Marcus-Reiss/CAD-Backup-LEMI/Backup-20241219-20250121T215628Z-001/Backup-20241219/LEMI_platform_v2024/Parts_new/Sala-de-controle/karman-office-armchair-with-glides-option-1.snapshot.5/Rendering/Karman 004 02a.png

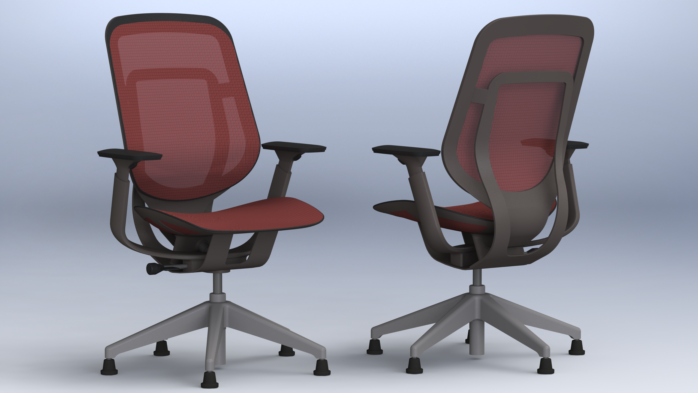
Backup-20241219-20250121T215628Z-001/Backup-20241219/LEMI_platform_v2024/Parts_new/Sala-de-controle/karman-office-armchair-with-glides-option-1.snapshot.5/Rendering/Karman 004 02a.png
