Marcus-Reiss/CAD-Backup-LEMI/Backup_20250225/LEMI_platform_v2024/Parts_new/Sala-de-controle/karman-office-armchair-with-glides-option-1.snapshot.5/Rendering/karman r-100 g-50 b100.png

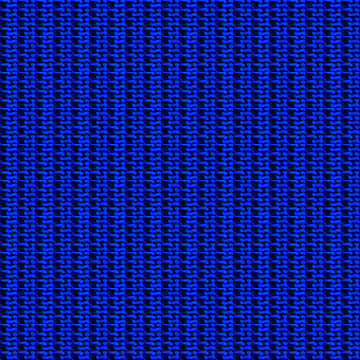
Backup_20250225/LEMI_platform_v2024/Parts_new/Sala-de-controle/karman-office-armchair-with-glides-option-1.snapshot.5/Rendering/karman r-100 g-50 b100.png
