Marcus-Reiss/CAD-Backup-LEMI/Backup_20250225/LEMI_platform_v2024/Mapa-Misturadores_LEMI-v2024/LowPressure_Setup1_XYZcoordinates.IGS.txt

SolidWorks IGES file using analytic representation for surfaces         S      1
1H,,1H;,5HPart1,128HC:\Users\IGOR RANGEL\Documents\LEMI\3Dmap\LEMI_platfG      1
orm_v2024\Mapa-Misturadores_LEMI-v2024\LowPressure_Setup1_XYZcoordinatesG      2
.IGS,15HSolidWorks 2023,15HSolidWorks 2023,32,308,15,308,15,5HPart1,1., G      3
2,2HMM,50,0.125,13H241102.171719,1E-08,499990.,11HIGOR RANGEL,,11,0,13H2G      4
41102.171719;                                                           G      5
     116       1       0       0       0                        00000000D      1
     116       0       0       1       0                               0D      2
     116       2       0       0       0                        00000000D      3
     116       0       0       1       0                               0D      4
     116       3       0       0       0                        00000000D      5
     116       0       0       1       0                               0D      6
     116       4       0       0       0                        00000000D      7
     116       0       0       1       0                               0D      8
     116       5       0       0       0                        00000000D      9
     116       0       0       1       0                               0D     10
     116       6       0       0       0                        00000000D     11
     116       0       0       1       0                               0D     12
     116       7       0       0       0                        00000000D     13
     116       0       0       1       0                               0D     14
     116       8       0       0       0                        00000000D     15
     116       0       0       1       0                               0D     16
     116       9       0       0       0                        00000000D     17
     116       0       0       1       0                               0D     18
     116      10       0       0       0                        00000000D     19
     116       0       0       1       0                               0D     20
     116      11       0       0       0                        00000000D     21
     116       0       0       1       0                               0D     22
     116      12       0       0       0                        00000000D     23
     116       0       0       1       0                               0D     24
     116      13       0       0       0                        00000000D     25
     116       0       0       1       0                               0D     26
     116      14       0       0       0                        00000000D     27
     116       0       0       1       0                               0D     28
     116      15       0       0       0                        00000000D     29
     116       0       0       1       0                               0D     30
     116      16       0       0       0                        00000000D     31
     116       0       0       1       0                               0D     32
     116      17       0       0       0                        00000000D     33
     116       0       0       1       0                               0D     34
     116      18       0       0       0                        00000000D     35
     116       0       0       1       0                               0D     36
     116      19       0       0       0                        00000000D     37
     116       0       0       1       0                               0D     38
     116      20       0       0       0                        00000000D     39
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
     402       0       0      16      15                3DSKETCH       1D    508
     314     270       0       0       0                        00000200D    509
     314       0       8       1       0                               0D    510
116,2400.,1025.,-19080.,;                                              1P      1
116,2050.,1025.,-19080.,;                                              3P      2
116,1680.,1025.,-19080.,;                                              5P      3
116,2400.,662.,-19080.,;                                               7P      4
116,2063.710678119,662.,-19080.,;                                      9P      5
116,2055.348877629,662.704155423,-19080.,;                            11P      6
116,2049.138564487,664.170579093,-19080.,;                            13P      7
116,2044.5765065,665.806023374,-19080.,;                              15P      8
116,2038.765908876,668.666889248,-19080.,;                            17P      9
116,2033.093103225,672.470718351,-19080.,;                            19P     10
116,2028.355339059,676.644660941,-19080.,;                            21P     11
116,1854.17766953,850.82233047,-19080.,;                              23P     12
116,2400.,200.,-19080.,;                                              25P     13
116,1995.710678119,200.,-19080.,;                                     27P     14
116,1989.309977636,200.411382018,-19080.,;                            29P     15
116,1982.84984418,201.682312241,-19080.,;                             31P     16
116,1976.5765065,203.806023374,-19080.,;                              33P     17
116,1969.571678389,207.376618,-19080.,;                               35P     18
116,1964.704420392,210.774855236,-19080.,;                            37P     19
116,1960.355339059,214.644660941,-19080.,;                            39P     20
116,1555.17766953,619.82233047,-19080.,;                              41P     21
116,1150.,1025.,-19080.,;                                             43P     22
116,850.,1025.,-19080.,;                                              45P     23
116,400.,1025.,-19080.,;                                              47P     24
116,361.751666746,1025.,-19078.167131998,;                            49P     25
116,329.307433241,1025.,-19073.703646167,;                            51P     26
116,299.100864855,1025.,-19067.065064979,;                            53P     27
116,272.770546388,1025.,-19059.226404848,;                            55P     28
116,237.07420108,1025.,-19045.315184528,;                             57P     29
116,205.138467915,1025.,-19029.32647096,;                             59P     30
116,176.780825428,1025.,-19011.923485314,;                            61P     31
116,148.979949959,1025.,-18991.430464915,;                            63P     32
116,117.157287525,1025.,-18962.842712475,;                            65P     33
116,90.619203002,1025.,-18933.541954021,;                             67P     34
116,68.932834013,1025.,-18904.487263794,;                             69P     35
116,52.628181233,1025.,-18878.325035047,;                             71P     36
116,34.967722097,1025.,-18843.558662531,;                             73P     37
116,19.307056975,1025.,-18802.77167072,;                              75P     38
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
