Marcus-Reiss/CAD-Backup-LEMI/Backup_20250225/LEMI_platform_v2024/Projeto Separador/Imagens Comporta/Imagem.pptx

## Comporta

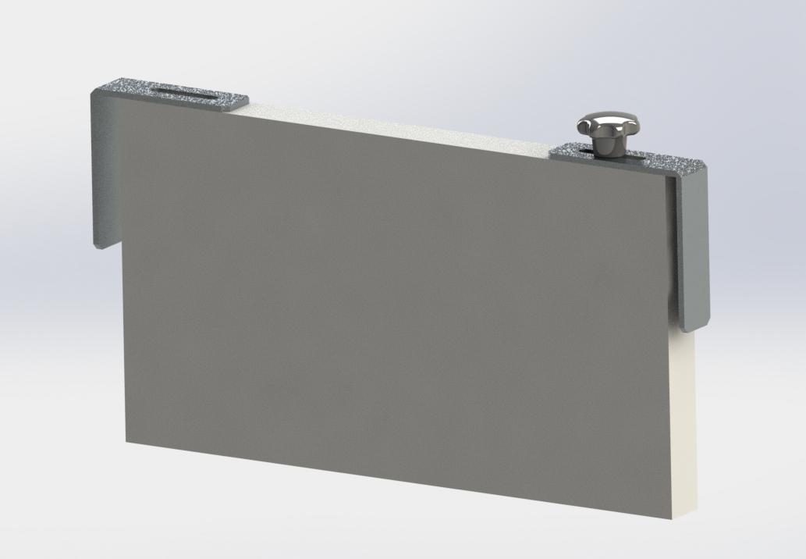
[picture p3: figure]
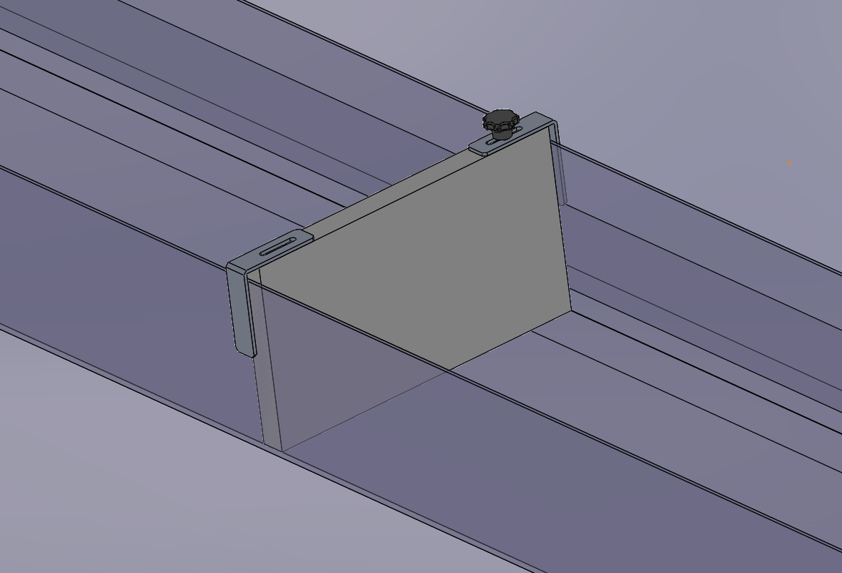
[picture p4: figure]
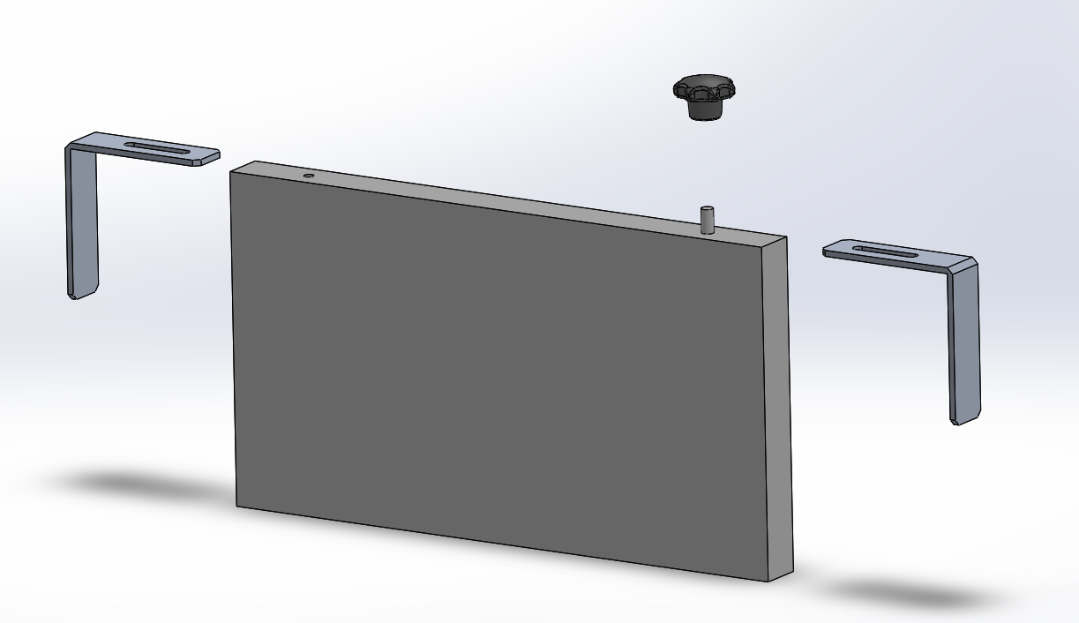
[picture p5: figure]
