Marcus-Reiss/CAD-Backup-LEMI/Backup-20241219-20250121T215628Z-001/Backup-20241219/LEMI_platform_v2024/Projeto Separador/Imagens Comporta/Comporta.PNG

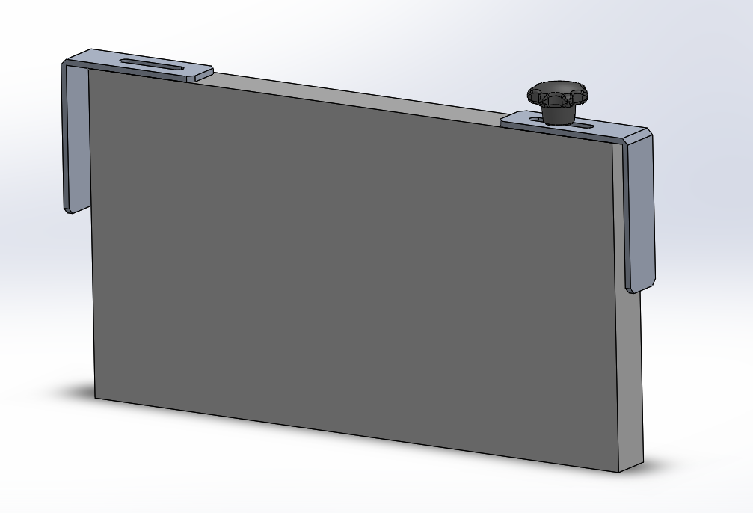
Backup-20241219-20250121T215628Z-001/Backup-20241219/LEMI_platform_v2024/Projeto Separador/Imagens Comporta/Comporta.PNG
