Marcus-Reiss/CAD-Backup-LEMI/Backup-20241219-20250121T215628Z-001/Backup-20241219/LEMI_platform_v2024/Projeto Separador/Imagens tubo ajustavel/WhatsApp Image 2019-05-02 at 08.36.58.jpeg

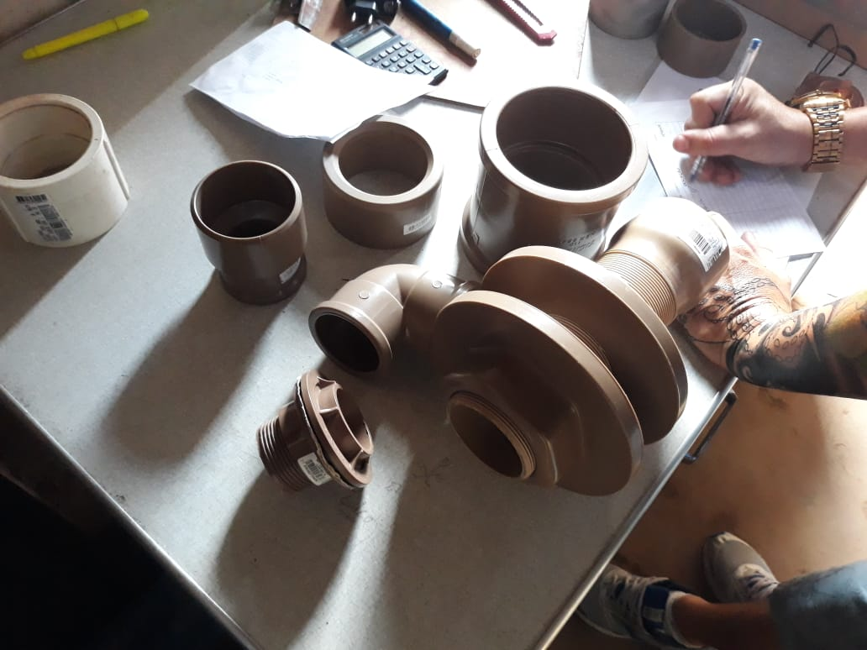
Backup-20241219-20250121T215628Z-001/Backup-20241219/LEMI_platform_v2024/Projeto Separador/Imagens tubo ajustavel/WhatsApp Image 2019-05-02 at 08.36.58.jpeg
