Marcus-Reiss/CAD-Backup-LEMI/Backup_20250225/LEMI_platform_v2024/Parts_new/Nova estrutura raios gamma 2024/CONTAPDF_900704486684.pdf

## IGOR RANGEL CORREA FERREIRA R FRANCISCO GENTIL DE GUZZI 605 AP 3 PQ S F JARDIM 13563-360 SAO CARLOS SP

### Nota Fiscal

### Conta de Energia Elétrica Nº 355746883 Série C Data de Emissão: 26/03/2024

### Data de Apresentação: 01/04/2024

### Pág: 01 de 01 Conta Contrato N° 310134338550

### Leitura Próximo Mês: 24/04/2024

Lote | Roteiro de leitura | N°. Medidor | PN
16 | SACBU223-00000388 | 22953156 | 717821069

## Reservado ao Fisco F9B6.3183.D08E.EDB9.543D.EF03.6CC7.0E30

Mantenha seus dados sempre atualizados, alguns itens determinam a tarifa e tributação de sua fatura de energia elétrica. Solicite os serviços disponíveis em nosso site com rapidez e segurança e reserve mais tempo para você em seu dia-a-dia. Mais informações acesse o endereço que consta no verso de sua conta.

IGOR RANGEL CORREA FERREIRA
R FRANCISCO GENTIL DE GUZZI, 605 AP 3 PQ S F JARDIM
13563-360 SAO CARLOS - SP

CPF: 105.638.006-31
CLASSIFICAÇÃO: Convencional B1 Residencial - Bifásico 220 / 127 V

0800 010 1010

## www.cpfl.com.br

## 717821069 INSTALAÇÃO

4001679179

MAR/2024 | 08/04/2024 | **********

Cod.
115

Descrição da Operação
N° 900704486684

Mês
Ref.

Quant.
Faturada

Unid.
Med.

Tarifa com
Tributos R$

Valor Total
da Operação
R$

Base Cálculo
ICMS R$

Aliq.
ICMS

ICMS Base Cálculo
PIS/COFINS

PIS
0,83%

COFINS
3,83%
0605 Consumo Uso Sistema [KWh]-TUSD | MAR/24 | 89,000 | kWh | 0,38977529 | 34,69 | 34,69 | 0,29 | 1,33
0601 Consumo - TE | MAR/24 | 89,000 | kWh | 0,33449439 | 29,77 | 29,77 | 0,25 | 1,14
Total Distribuidora | | | | | 64,46
Total Consolidado | 64,46 | 64,46 | 0,54 | 2,47

Bandeiras
Tarifárias
(Dias)

Verde
06 Dias
Verde
26 Dias
2024 MAR lllllllllllllllllllllllllllllllllllllllllllllllllllllllllllllllllllllllllll | 89 | 32 | Consumo | TUSD | TE
Consumo kWh | 0,37162000 | 0,31884000
Nº | Energia | Leitura | Leitura | Fator | ConsumoTaxa de Perda | Leitura
26/03/2024 24/02/2024 | Multipl. | [kWh] | [%] | Próximo Mês
22953156 | Ativa | 11074 | 10985 | 1,00 | 89 | 24/04/2024

### Para consulta dos indicadores acesse nosso site www.cpfl.com.br

Junto com sua fatura segue Contrato de Adesão.
CDE Escassez Hídrica TUSD R$ 0,41 TE R$ 0,33
Não Pague. Para sua comodidade o valor devido R$ 64,46 será cobrado, sem acréscimo em conta futura. Caso não queira esta opção, é possível solicitar o código de barras
para pagamento e o cancelamento desse serviço através

de nossos canais de atendimento.

CódDébAut-Banco
310134338550

Nota Fiscal
Conta de Energia Elétrica
N° 355746883 Série C

### Total a Pagar (R$)

**********

### Data de Vencimento

08/04/2024

## NÃO RECEBER. O VALOR DESTA FATURA SERÁ INSERIDO EM CONTA FUTURA ISENTO DE ENCARGOS SAIBA MAIS EM: www.cpfl.com.br/contaminima
