Marcus-Reiss/CAD-Backup-LEMI/Backup_20250225/LEMI_platform_v2024/Parts_new/Sala-de-controle/254839.pdf

## HIDROTUBE HIDRAULICA INDL LTDA

### AV. AMBROSIO FUMAGALLI, 1907 13.485-333 - LIMEIRA - SP CNPJ: 02.587.023/0001-70 - IE 417.148.125.112 FONE: (19) 3452-5313

## Orçamento de Venda - Nº 254839

1/3

04/03/2024
Revisão.: 07/03/2024

# CONSUMIDOR 8

À
FUNDACAO DE APOIO A UNIVERSIDADE DE SAO | CNPJ : 68.314.830/0001-27
Endereço: AVENIDA AFRANIO PEIXOTO,14
Bairro: BUTANTA | Cidade: SAO PAULO | UF: SP CEP: 05.507-000
A/C ANDRE | Fone: ( )
Depto: | Fax: ( )
E-mail: la.buenomonteiro@gmail.com .
Item | Código | Descrição | ICMS | IPI | NCM | Qtde | UN | Unitário | Total | Entrega Vlr. ST
1 | 3894 | TUBO INOX 304L SCH-40s S/C. 2 | 18,00% 0,00 % 7306.40.00 | 60,00 | MT | 317,3850 | 19.043,10 10 DIAS | 0,00
2 | 3897 | TUBO INOX 304L SCH-40s S/C. 4 | 18,00% 0,00 % 7306.40.00 | 6,00 | MT | 984,8617 | 5.909,17 10 DIAS | 0,00
3 | 7466 | FLANGE INOX 304L W.N ANSI 300 RF 2 * | 0,00% 0,00 % 7307.21.00 | 35,00 | PC | 543,3751 | 19.018,13 5 DIAS | 0,00
4 | 7336 | FLANGE INOX 304L W.N ANSI 150 RF 2 | 18,00% 0,00 % 7307.21.00 | 8,00 | PC | 396,9000 | 3.175,20 5 DIAS | 0,00
5 | 31073 | JUNTA | METALICA | ESPIRALADA
| | I304/GRAF/AC RF 300 2
18,00% 0,00 % 8484.20.00 | 50,00 | PC | 20,9070 | 1.045,35 IMEDIATO 0,00
6 | 7463 | FLANGE INOX 304L W.N ANSI 300 RF 1 | 0,00% 0,00 % 7307.21.00 | 4,00 | PC | 272,4750 | 1.089,90 5 DIAS | 0,00
7 | 31070 | JUNTA METALICA ESPIRALADA I304/GRAF/AC RF 300 1
8 | 34388 | VALVULA DE ESFERA DIRECIONAL MULTIVIAS DIAMETRO 2" PASSAGEM PLENA ACO INOX MICROFUNDIDO ASTM A351 GRAU CF8 SI/E.316 FLANGE SOLDADO CLASSE 300 (ASME B16.5) RANHURA ESPIRAL (MSSP-6) VEDACOES EM PTFE REFORCADO ACIONAMENTO MANUAL
9 | 34388 | VALVULA DE ESFERA DIRECIONAL MULTIVIAS DIAMETRO 2" PASSAGEM PLENA ACO INOX MICROFUNDIDO ASTM A351 GRAU CF8 ESFERA EM ACO INOX MICROFUNDIDO ASTM A351 GRAU CF8M E HASTE EM ACO INOX AISI 304, COM PARAFUSOS EM ACO CARBONO ZINCADO (SAE J 429) E PORCAS EM ACO CARBONO (SAE J 995) FLANGE SOLDADO CLASSE 150 (ASME B16.5) RANHURA ESPIRAL (MSSP-6) VEDACOES EM PTFE PURO ACIONAMENTO MANUAL POR ALAVANCA GIRO 90 GRAU
10 | 28370 | VAL.ESF.TRIP.S-I304 TP P.PLENA FL-300 2 MGA
18,00% 0,00 % 8484.20.00 | 4,00 | PC | 12,2725 | 49,09 IMEDIATO 0,00
0,00% 0,00 % 8481.80.95 | 1,00 | PC 4.685,1100 | 4.685,11 25 DIAS | 0,00
0,00% 0,00 % 8481.80.95 | 2,00 | PC 3.982,6350 | 7.965,27 25 DIAS | 0,00
0,00% 0,00 % 8481.80.95 | 3,00 | PC 1.326,3467 | 3.979,04 15 DIAS | 0,00

### FONE: (19) 3452-5313

## Orçamento de Venda - Nº 254839

2/3

Item | Código | Descrição | ICMS | IPI | NCM | Qtde | UN | Unitário | Total | Entrega Vlr. ST
11 | 28730 | VALVULA DE ESFERA TRIPARTIDA SERIE
| | 1000, CLASSE 300, DIAMETRO 2" PASSAGEM PLENA CONSTRUCAO EM INOX MICROFUNDIDO ASTM A351 GRAU CF8 ESFERA EM ACO INOX MICROF. ASTM A351 GR. CF8 E HASTE EM ACO INOX AISI 304, COM PARAFUSOS EM ASTM A193 GR. B7 SEM REVESTIMENTO E PORCAS EM ASTM
A194 | GR. | 2H | SEM | REVESTIMENTO
| | CONEXAO FLANGE CLASSE 300 (CONFORME ASME B16.5)
RESSALTO | COM | RANHURA | ESPIRAL
| | (CONFORME MSS SP-6) VEDACOES EM PTFE PURO
ACIONAMENTO | PNEUMATICO | POR
| | ATUADOR RETORNO MOLA SR85 COM ENTRADA DE AR PARA ACIONAMENTO DE 6 BAR E SOLENOIDE 3/2 24VCC E INDICADOR DE POSICAO E06
0,00% 0,00 % 8481.80.95 | 3,00 | PC 3.065,0400 | 9.195,12 25 DIAS | 0,00
12 | 7466 | FLANGE INOX 304L W.N ANSI 300 RF 2 * | 0,00% 0,00 % 7307.21.00 | 4,00 | PC | 543,3750 | 2.173,50 5 DIAS | 0,00
13 | 9103 | VAL.RETENCAO TIPO DISCO INOX WAFER VRD32 2" VEDAÇÃO EM TEFLON | 0,00% 0,00 % 8481.30.00 | 2,00 | PC | 801,4500 | 1.602,90 45 DIAS | 0,00
14 | 7466 | FLANGE INOX 304L W.N ANSI 300 RF 2 * | 0,00% 0,00 % 7307.21.00 | 2,00 | PC | 543,3750 | 1.086,75 5 DIAS | 0,00
15 | 5684 | REDUCAO CONC. INOX 304L SCH-40s 4 X 2 * 0,00% 0,00 % 7307.23.00 | 4,00 | PC | 281,9250 | 1.127,70 5 DIAS | 0,00
16 | 29887 | VALVULA | DE | ESFERA | DIRECIONAL
| | MULTIVIAS DIAMETRO 1" PASSAGEM PLENA ACO INOX MICROFUNDIDO ASTM A351 GRAU CF8 ESFERA EM ACO INOX MICROFUNDIDO ASTM A351 GRAU CF8M E HASTE EM ACO INOX AISI 304, COM PARAFUSOS EM ACO INOX (AISI 304) E PORCAS EM ACO INOX (AISI 304) FLANGE SOLDADO CLASSE 150 (ASME B16.5) RANHURA ESPIRAL (MSSP-6) VEDACOES EM PTFE REFORCADO ACIONAMENTO MANUAL POR ALAVANCA GIRO 90 GRAUS
0,00% 0,00 % 8481.80.95 | 1,00 | PC 2.364,8000 | 2.364,80 15 DIAS | 0,00
17 | 29863 | CURVA R.L. 90 INOX 304L SCH-40S 2 HT | 18,00% 3,25 % 7307.23.00 | 20,00 | PC | 59,8990 | 1.197,98 IMEDIATO 0,00 ST (R$) 0,00 IPI (R$) 38,93 FCP ST (R$) 0,00 TOTAL (R$) 84.747,04

Obs.: FATURAMENTO MEDIANTE APROVACAO DO CADASTRO

CONDIÇÕES DE PAGAMENTO | 28 DDL
VALIDADE DA PROPOSTA | 5 DIAS
PRAZO DE ENTREGA | ACIMA - SALVO VENDA PRÉVIA

### FONE: (19) 3452-5313

## Orçamento de Venda - Nº 254839

3/3

Item | Código | Descrição | ICMS | IPI | NCM | Qtde | UN | Unitário | Total | Entrega Vlr. ST
LOCAL DE ENTREGA | SEU ALMOXARIFADO
TIPO DE FRETE | CIF
PESO APROXIMADO | 757 KG

| | | | | | | | | | Atenciosamente,

DOUGLAS ALBERTO SILVA MANCINI
