Marcus-Reiss/CAD-Backup-LEMI/Backup-20241219-20250121T215628Z-001/Backup-20241219/LEMI_platform_v2024/Parts_new/aluminium_profile/profile-aluminium-3030/Aluminium Profile 3030 30x30 mm/Aluminium Profile 3030 30x30 mm.JPG

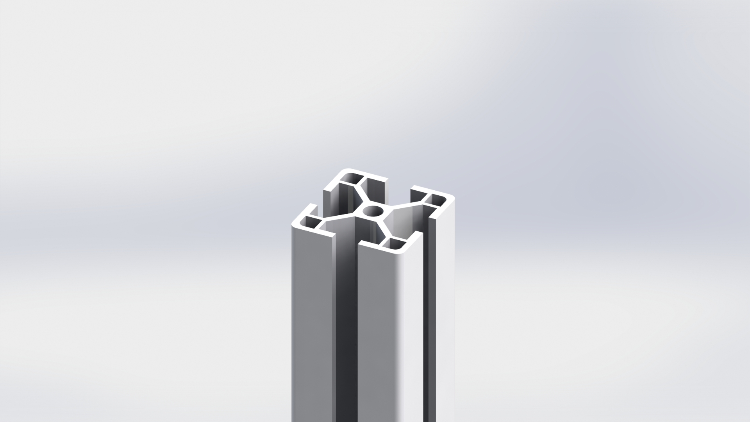
Backup-20241219-20250121T215628Z-001/Backup-20241219/LEMI_platform_v2024/Parts_new/aluminium_profile/profile-aluminium-3030/Aluminium Profile 3030 30x30 mm/Aluminium Profile 3030 30x30 mm.JPG
