Marcus-Reiss/CAD-Backup-LEMI/Backup-20241219-20250121T215628Z-001/Backup-20241219/LEMI_platform_v2024/Parts_new/aluminium_profile/weldments/Profile T-Slot 50 (2).JPG

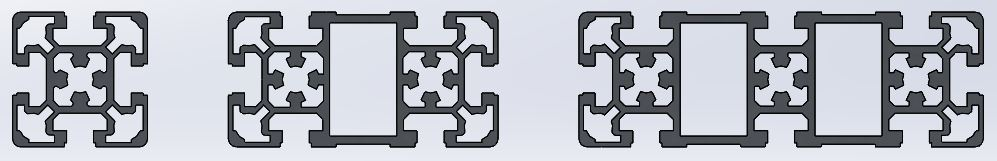
Backup-20241219-20250121T215628Z-001/Backup-20241219/LEMI_platform_v2024/Parts_new/aluminium_profile/weldments/Profile T-Slot 50 (2).JPG
