Marcus-Reiss/CAD-Backup-LEMI/Backup-20241219-20250121T215628Z-001/Backup-20241219/LEMI_platform_v2024/Parts_new/drawer_Slide/Guia/Riel50CM_completo.bmp

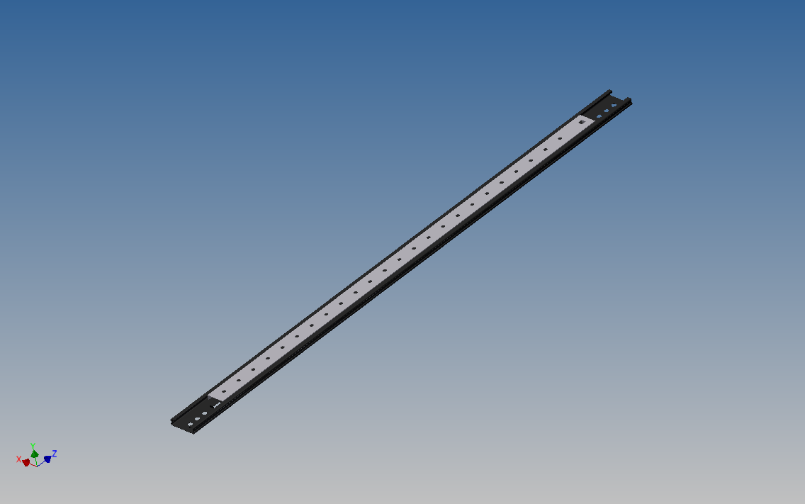
Backup-20241219-20250121T215628Z-001/Backup-20241219/LEMI_platform_v2024/Parts_new/drawer_Slide/Guia/Riel50CM_completo.bmp
