Marcus-Reiss/CAD-Backup-LEMI/Backup-20241219-20250121T215628Z-001/Backup-20241219/LEMI_platform_v2024/Parts_new/pneumatic-parts-1.snapshot.30/pnomatik.png

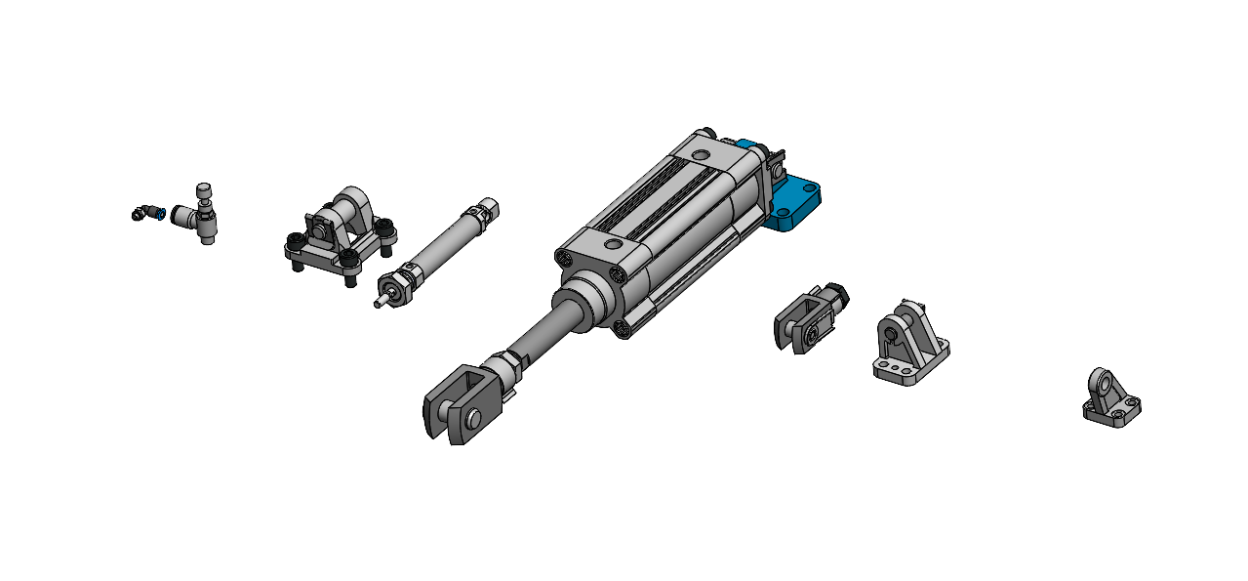
Backup-20241219-20250121T215628Z-001/Backup-20241219/LEMI_platform_v2024/Parts_new/pneumatic-parts-1.snapshot.30/pnomatik.png
