Marcus-Reiss/CAD-Backup-LEMI/Backup-20241219-20250121T215628Z-001/Backup-20241219/LEMI_platform_v2024/Parts_new/Valvulas e flanges/abracadeira-u-/Abra├ºadeira ├ÿ64 - 2.1_2_.JPG

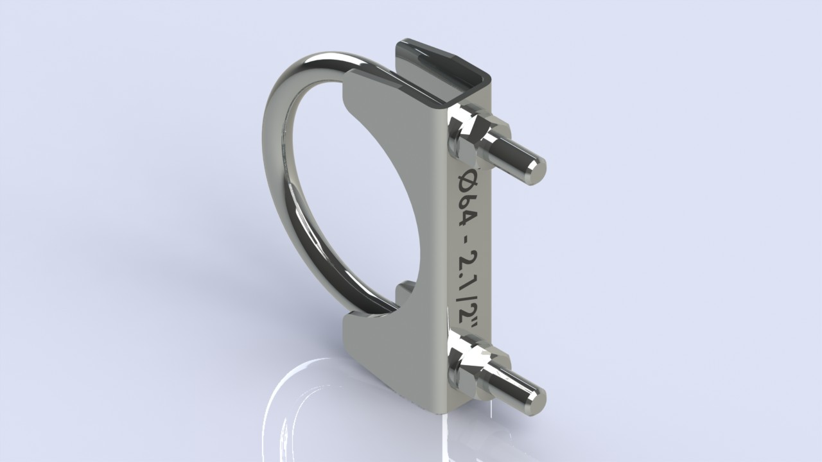
Backup-20241219-20250121T215628Z-001/Backup-20241219/LEMI_platform_v2024/Parts_new/Valvulas e flanges/abracadeira-u-/Abra├ºadeira ├ÿ64 - 2.1_2_.JPG
