Marcus-Reiss/CAD-Backup-LEMI/Backup-20241219-20250121T215628Z-001/Backup-20241219/LEMI_platform_v2024/Parts_new/Valvulas e flanges/pipe-exhaust-clamp-m8-54-mm-u-bolt-8-54-1.snapshot.5/Render.png

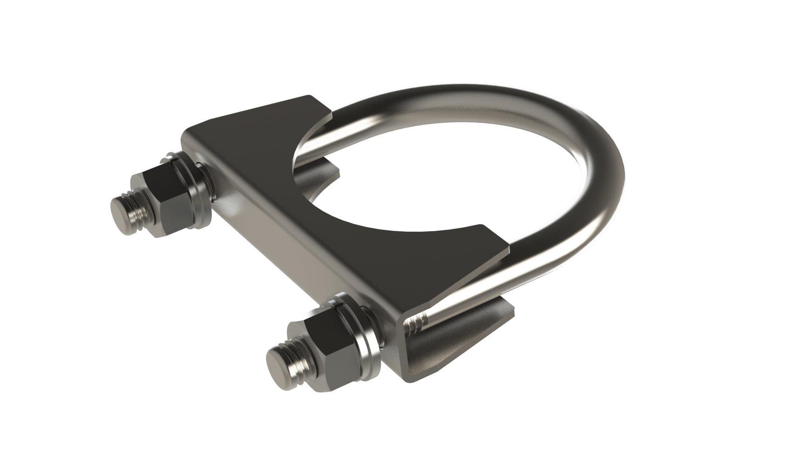
Backup-20241219-20250121T215628Z-001/Backup-20241219/LEMI_platform_v2024/Parts_new/Valvulas e flanges/pipe-exhaust-clamp-m8-54-mm-u-bolt-8-54-1.snapshot.5/Render.png
