Marcus-Reiss/CAD-Backup-LEMI/Backup-20241219-20250121T215628Z-001/Backup-20241219/LEMI_platform_v2024/Parts_new/CAD Estrutura Raios Gama/guia/Montagem Guia.SLDASM

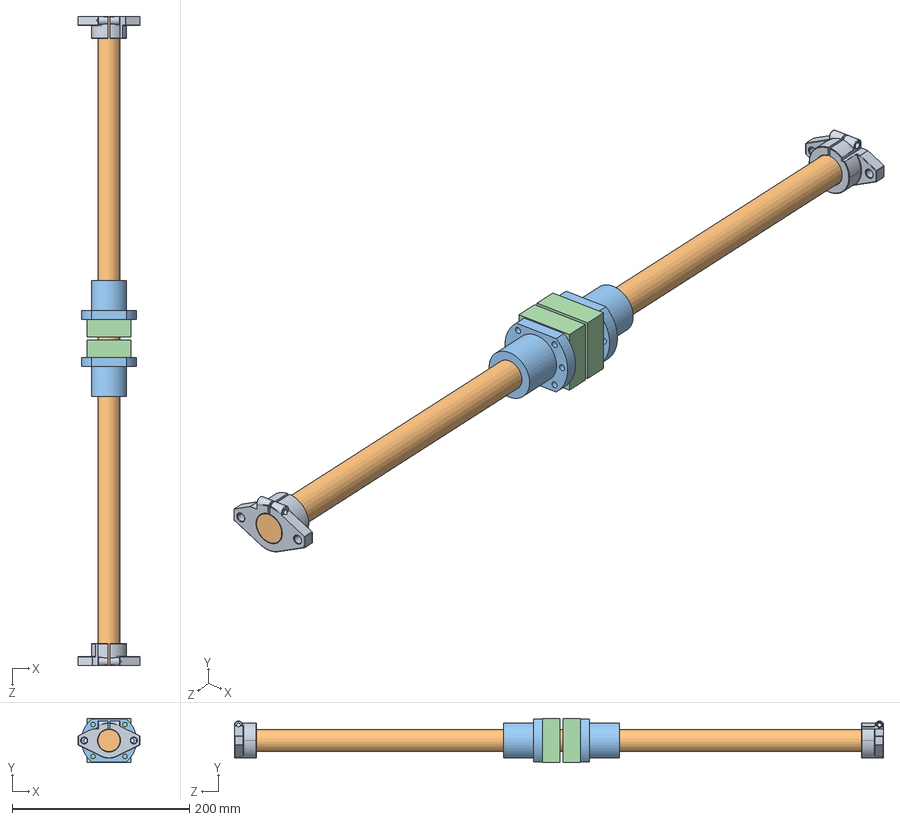
[picture p29: CAD file, 2025-04-27]
Backup-20241219-20250121T215628Z-001/Backup-20241219/LEMI_platform_v2024/Parts_new/CAD Estrutura Raios Gama/guia/Montagem Guia.SLDASM
70.0 x 50.0 x 732.5 mm
Shaft support SHF25 x 2
guia
LMF25UU x 2
bucha x 2
