Marcus-Reiss/CAD-Backup-LEMI/Backup-20241219-20250121T215628Z-001/Backup-20241219/LEMI_platform_v2024/Parts_new/Sala-de-controle/karman-office-armchair-with-glides-option-1.snapshot.5/Assemblies_&_Parts/Karman_004a.SLDASM

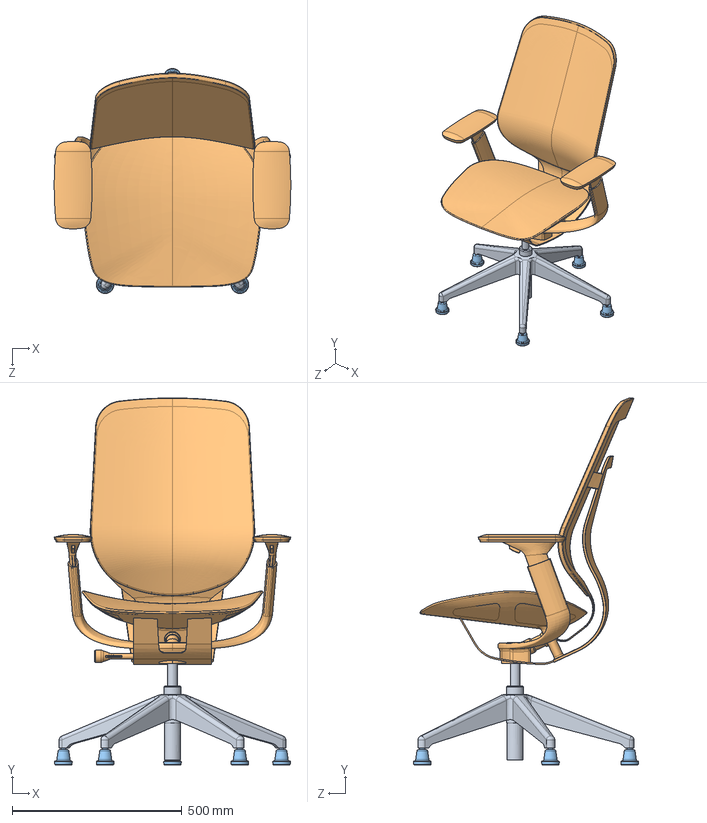
[picture p30: CAD file, 2025-04-27]
Backup-20241219-20250121T215628Z-001/Backup-20241219/LEMI_platform_v2024/Parts_new/Sala-de-controle/karman-office-armchair-with-glides-option-1.snapshot.5/Assemblies_&_Parts/Karman_004a.SLDASM
696.2 x 1080.0 x 662.3 mm
Karman_202
Karman_101a
Karman_211 x 5
