Marcus-Reiss/CAD-Backup-LEMI/Backup_CAD-LEMI_20240524/LEMI_platform_v2024/Parts_new/CAD Estrutura Raios Gama/Montagem0104.SLDASM

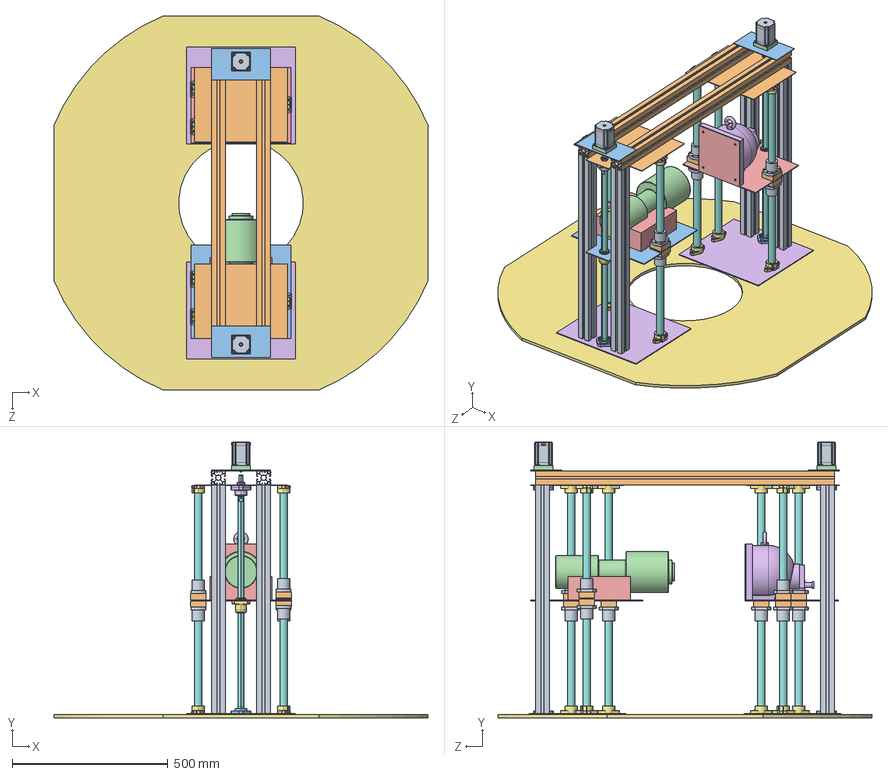
[picture p31: CAD file, 2025-04-27]
Backup_CAD-LEMI_20240524/LEMI_platform_v2024/Parts_new/CAD Estrutura Raios Gama/Montagem0104.SLDASM
1200.0 x 884.1 x 1200.0 mm
Perfilado - Especial 45x45 - 800mm x 4
Perfilado - Especial 45x45 - 960mm x 2
WTF2040_2ZZ_765_5LT_H1K_600300KFK_15FF_150_3 x 2
WTF2040_2ZZ_765_5LT_H1K_600300KFK_15FF_150_5 x 2
WTF2040_2ZZ_765_5LT_H1K_600300KFK_15FF_150_7 x 2
WTF2040_2ZZ_765_5LT_H1K_600300KFK_15FF_150_9 x 2
WTF2040_2ZZ_765_5LT_H1K_600300KFK_15FF_150_11 x 2
WTF2040_2ZZ_765_5LT_H1K_600300KFK_15FF_150_13 x 2
Stepper motor NEMA 23HS7430 x 2
chapa 2 mm x 2
chapa motor x 2
bucha do motor x 2
suporte emissor
Emissor
Shaft support SHF25 x 12
guia x 6
LMF25UU x 12
bucha x 12
suporte receptor
Receptor
apoio de montagem receptor
base movel x 2
Plataforma
