Marcus-Reiss/CAD-Backup-LEMI/Backup-20241219-20250121T215628Z-001/Backup-20241219/LEMI_platform_v2024/Parts_new/Sala-de-controle/Setup/G102.SLDASM

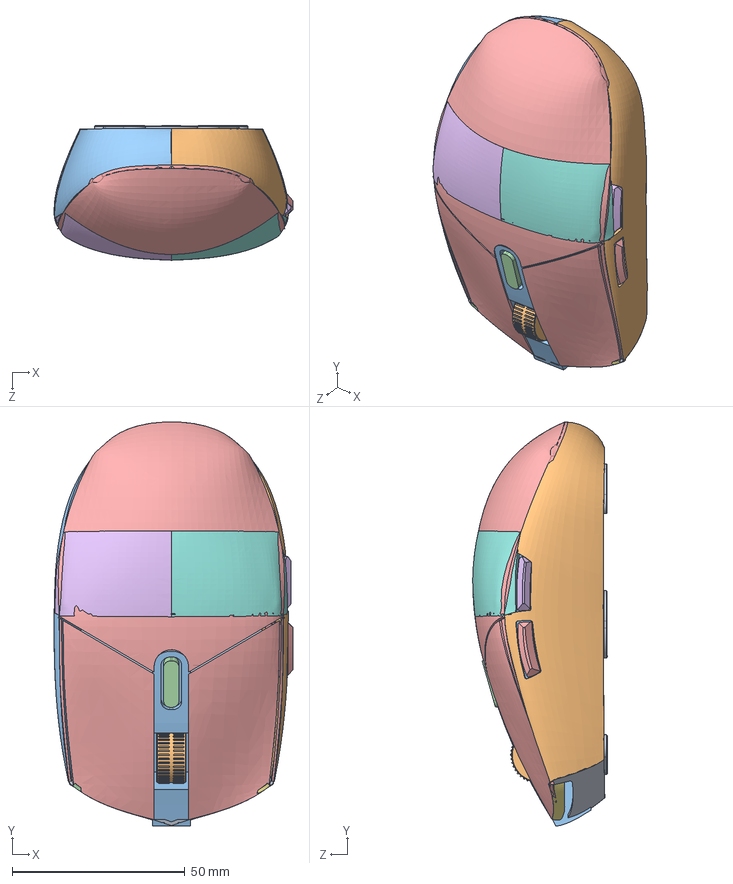
[picture p32: CAD file, 2025-04-27]
Backup-20241219-20250121T215628Z-001/Backup-20241219/LEMI_platform_v2024/Parts_new/Sala-de-controle/Setup/G102.SLDASM
69.3 x 117.1 x 39.0 mm
BottomPart.step
RightSidePart.step
LeftSidePart.step
TopLeftFrontPart.step
TopPart.step
TopMidLeftPart.step
TopRightFrontPart.step
TopMidRightPart.step
FrontPart.step
Mouse Wheel.step
MouseWheelBase.step
MiddleButton.step
M4.step
M5.step
