Marcus-Reiss/CAD-Backup-LEMI/Backup-20241219-20250121T215628Z-001/Backup-20241219/LEMI_platform_v2024/Parts_new/Valvulas e flanges/Pneumatic-valves/pneumatic-valve1pol-inox/pneumatic-valve1pol-inox.SLDASM

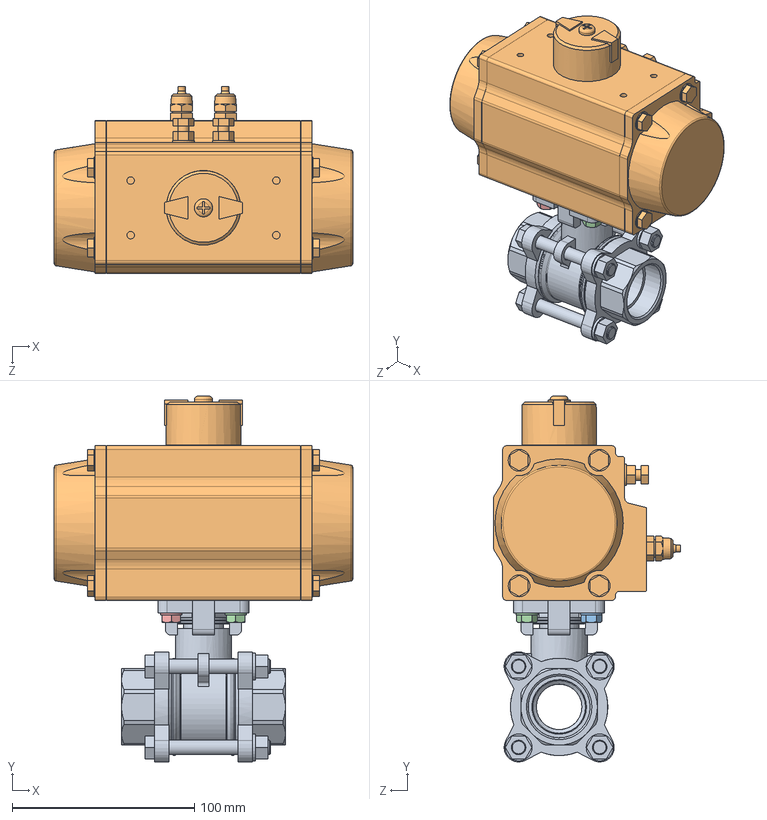
[picture p33: CAD file, 2025-04-27]
Backup-20241219-20250121T215628Z-001/Backup-20241219/LEMI_platform_v2024/Parts_new/Valvulas e flanges/Pneumatic-valves/pneumatic-valve1pol-inox/pneumatic-valve1pol-inox.SLDASM
164.0 x 201.1 x 102.6 mm
450071-25de_01
450071-25de_02
450071-25de_03
450071-25de_04
450071-25de_05
450071-25de_06
