Marcus-Reiss/CAD-Backup-LEMI/Backup-20241219-20250121T215628Z-001/Backup-20241219/LEMI_platform_v2024/Parts_new/Sala-de-controle/chair assembly.SLDASM

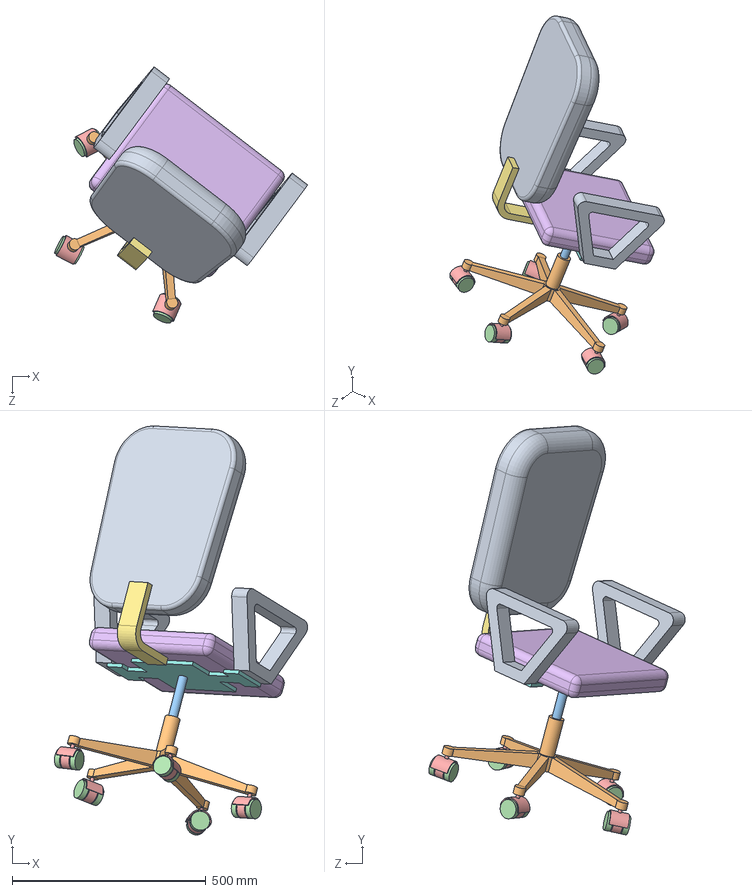
[picture p34: CAD file, 2025-04-27]
Backup-20241219-20250121T215628Z-001/Backup-20241219/LEMI_platform_v2024/Parts_new/Sala-de-controle/chair assembly.SLDASM
653.3 x 1055.8 x 661.7 mm
back rest
base legs
nuematic rod
wheel x 10
wheels x 5
ceat
ceat rest connector
ceat frame
hand rest x 2
