Marcus-Reiss/CAD-Backup-LEMI/Backup_CAD-LEMI_20240524/LEMI_platform_v2024/Parts_new/pneumatic-parts-1.snapshot.30/profil sıkıştırma sistemi test montajı.SLDASM

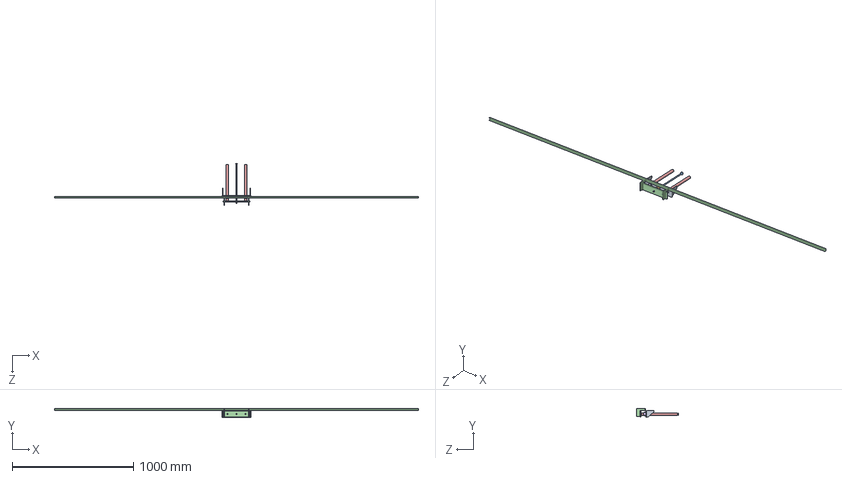
[picture p35: CAD file, 2025-04-27]
Backup_CAD-LEMI_20240524/LEMI_platform_v2024/Parts_new/pneumatic-parts-1.snapshot.30/profil sıkıştırma sistemi test montajı.SLDASM
3000.0 x 77.5 x 349.3 mm
şase piston bağlantı sacı
DIN_439_B___M22x1_5_F_
19216_DSNU_20_250_P____A___00__0_KS_
profil sıkıştırma sacı
piston destek mili x 2
PAP 20X23X20 x 2
