Marcus-Reiss/CAD-Backup-LEMI/Backup_CAD-LEMI_20240524/LEMI_platform_v2024/Parts_new/pneumatic-parts-1.snapshot.30/2676 SG-M16.SLDASM

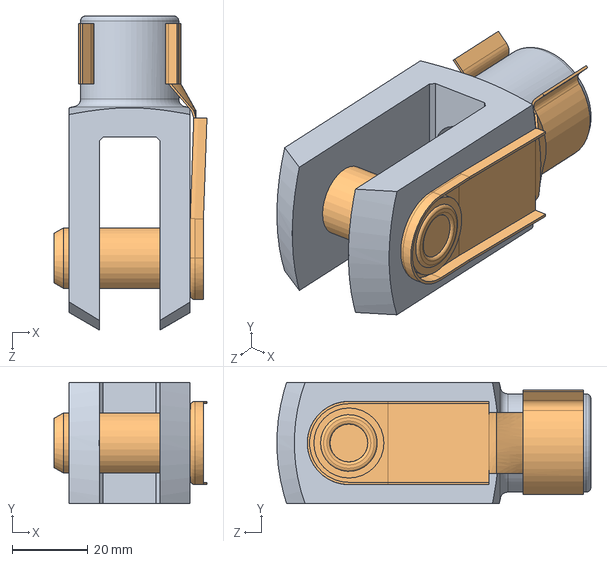
[picture p36: CAD file, 2025-04-27]
Backup_CAD-LEMI_20240524/LEMI_platform_v2024/Parts_new/pneumatic-parts-1.snapshot.30/2676 SG-M16.SLDASM
40.4 x 32.0 x 83.0 mm
2676 SG-M16---(GK)
200285 FKB-16X32
