Marcus-Reiss/CAD-Backup-LEMI/Backup-20241219-20250121T215628Z-001/Backup-20241219/LEMI_platform_v2024/Chapa45/Chapa45_v0_STL3D.STL

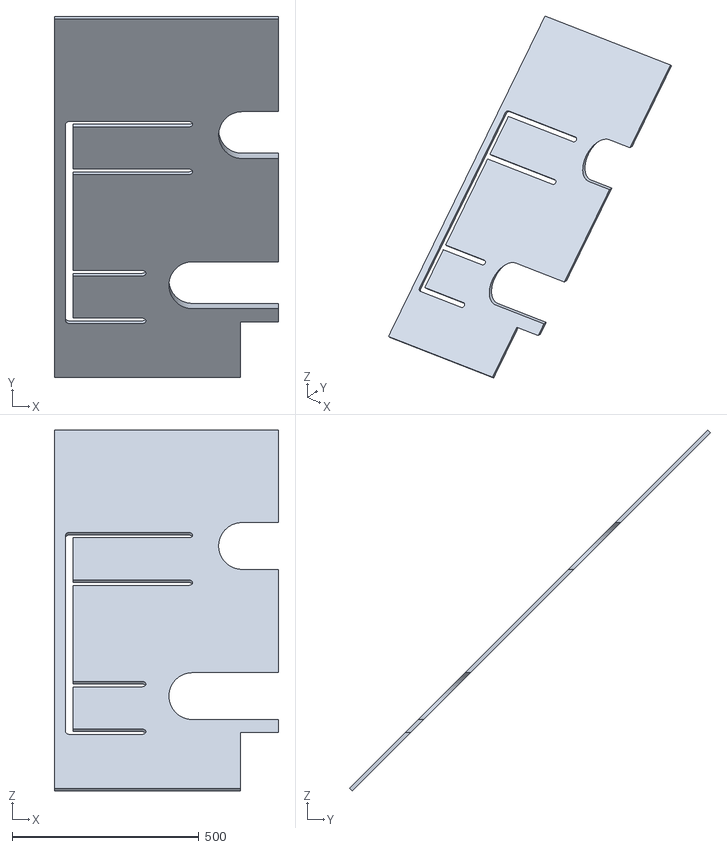
[picture p37: CAD file, 2025-04-27]
Backup-20241219-20250121T215628Z-001/Backup-20241219/LEMI_platform_v2024/Chapa45/Chapa45_v0_STL3D.STL
600.0 x 966.1 x 966.1
