Marcus-Reiss/CAD-Backup-LEMI/Backup-20241219-20250121T215628Z-001/Backup-20241219/LEMI_platform_v2024/Conjunto-Abraçadeiras-Aço-1020/Dupla-1pol.SLDPRT

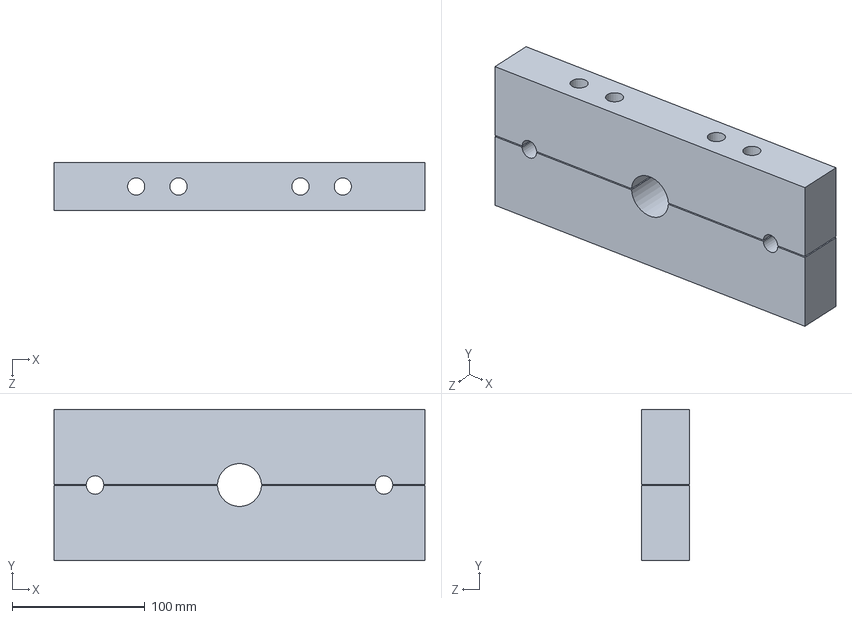
[picture p38: CAD file, 2025-04-27]
Backup-20241219-20250121T215628Z-001/Backup-20241219/LEMI_platform_v2024/Conjunto-Abraçadeiras-Aço-1020/Dupla-1pol.SLDPRT
280.0 x 114.0 x 36.0 mm
