Marcus-Reiss/CAD-Backup-LEMI/Backup-20241219-20250121T215628Z-001/Backup-20241219/LEMI_platform_v2024/Janela-Visualisacao/Janela_v0.SLDPRT

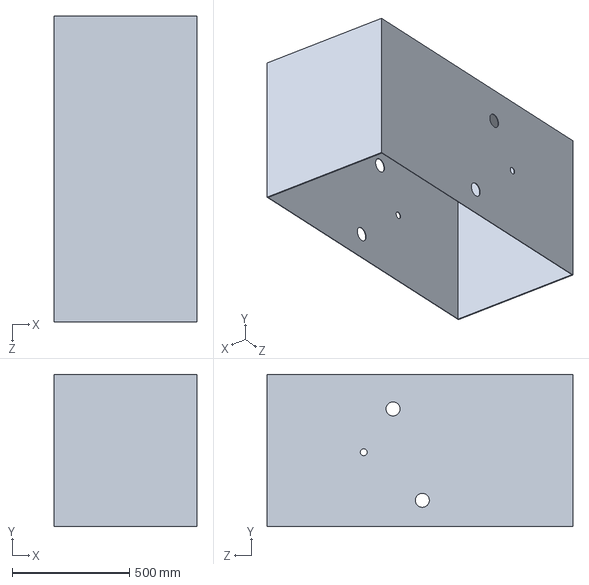
[picture p39: CAD file, 2025-04-27]
Backup-20241219-20250121T215628Z-001/Backup-20241219/LEMI_platform_v2024/Janela-Visualisacao/Janela_v0.SLDPRT
610.0 x 650.0 x 1305.0 mm
