Marcus-Reiss/CAD-Backup-LEMI/Backup-20241219-20250121T215628Z-001/Backup-20241219/LEMI_platform_v2024/Parts_new/Alteracoes-Edson/External_Tube_Drawing.SLDPRT

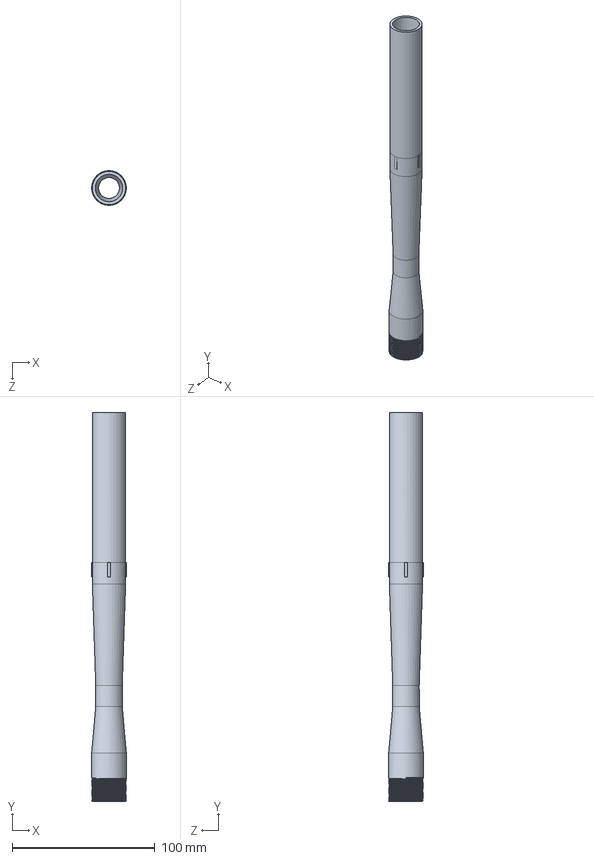
[picture p40: CAD file, 2025-04-27]
Backup-20241219-20250121T215628Z-001/Backup-20241219/LEMI_platform_v2024/Parts_new/Alteracoes-Edson/External_Tube_Drawing.SLDPRT
24.3 x 272.1 x 24.3 mm
