Marcus-Reiss/CAD-Backup-LEMI/Backup-20241219-20250121T215628Z-001/Backup-20241219/LEMI_platform_v2024/Parts_new/aluminium_profile/60x90-H.SLDPRT

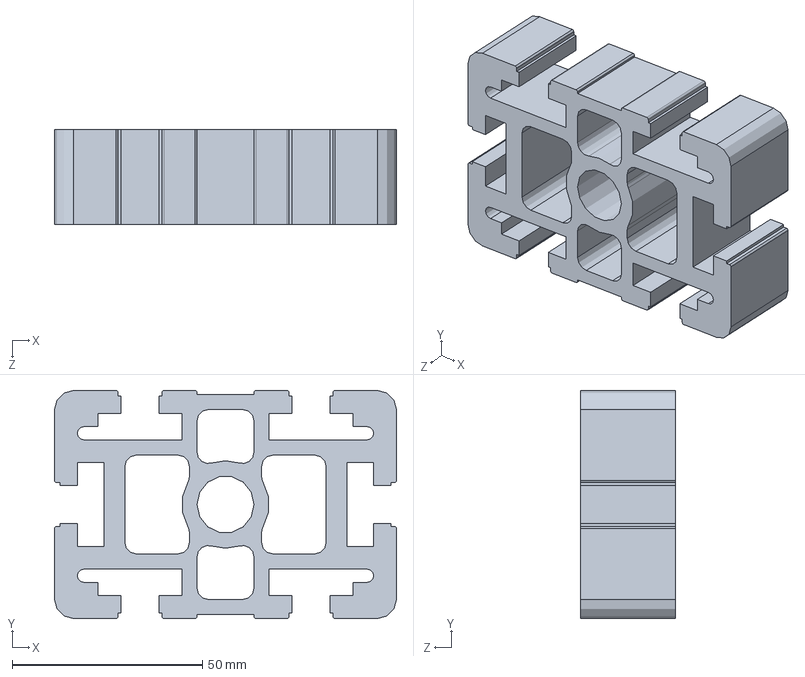
[picture p41: CAD file, 2025-04-27]
Backup-20241219-20250121T215628Z-001/Backup-20241219/LEMI_platform_v2024/Parts_new/aluminium_profile/60x90-H.SLDPRT
90.0 x 60.0 x 25.0 mm
