Marcus-Reiss/CAD-Backup-LEMI/Backup-20241219-20250121T215628Z-001/Backup-20241219/LEMI_platform_v2024/Parts_new/aluminium_profile/profile-aluminium-3030/Aluminium Profile 3030 30x30 mm/Aluminium Profile 3030 30x30 mm.STEP

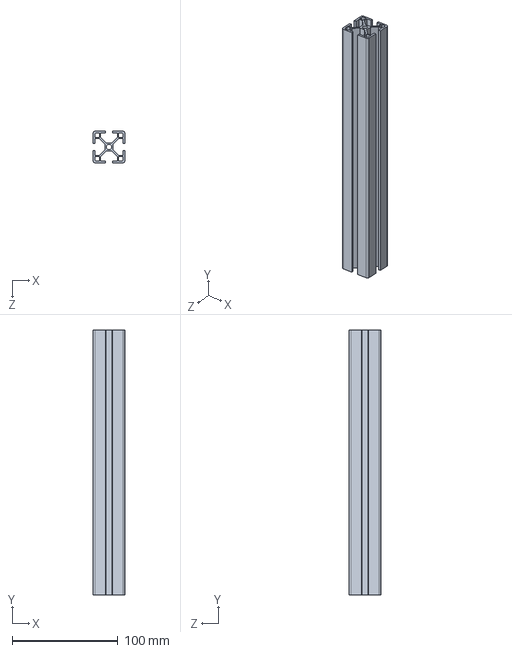
[picture p42: CAD file, 2025-04-27]
Backup-20241219-20250121T215628Z-001/Backup-20241219/LEMI_platform_v2024/Parts_new/aluminium_profile/profile-aluminium-3030/Aluminium Profile 3030 30x30 mm/Aluminium Profile 3030 30x30 mm.STEP
30.0 x 250.0 x 30.0 mm
