Marcus-Reiss/CAD-Backup-LEMI/Backup-20241219-20250121T215628Z-001/Backup-20241219/LEMI_platform_v2024/Parts_new/aluminium_profile/weldments/Part (Step)/50x150.STEP

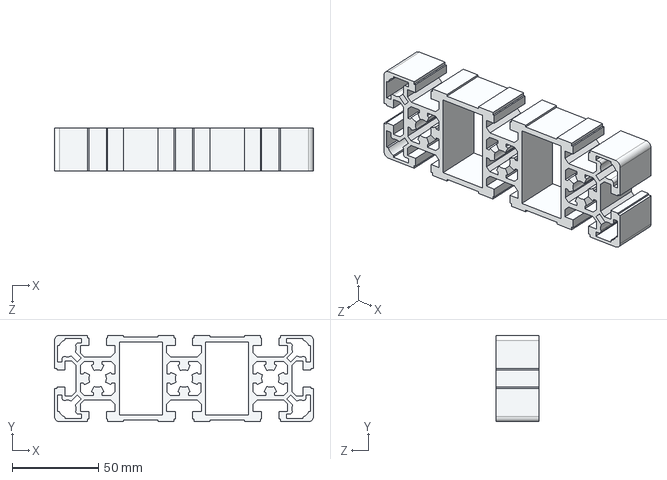
[picture p43: CAD file, 2025-04-27]
Backup-20241219-20250121T215628Z-001/Backup-20241219/LEMI_platform_v2024/Parts_new/aluminium_profile/weldments/Part (Step)/50x150.STEP
150.0 x 50.0 x 25.0 mm
