Marcus-Reiss/CAD-Backup-LEMI/Backup-20241219-20250121T215628Z-001/Backup-20241219/LEMI_platform_v2024/Parts_new/BASE Deslocamento Raios gama/Motor/Tech Makers-3D-AK23-15F6FN1_8.sldprt

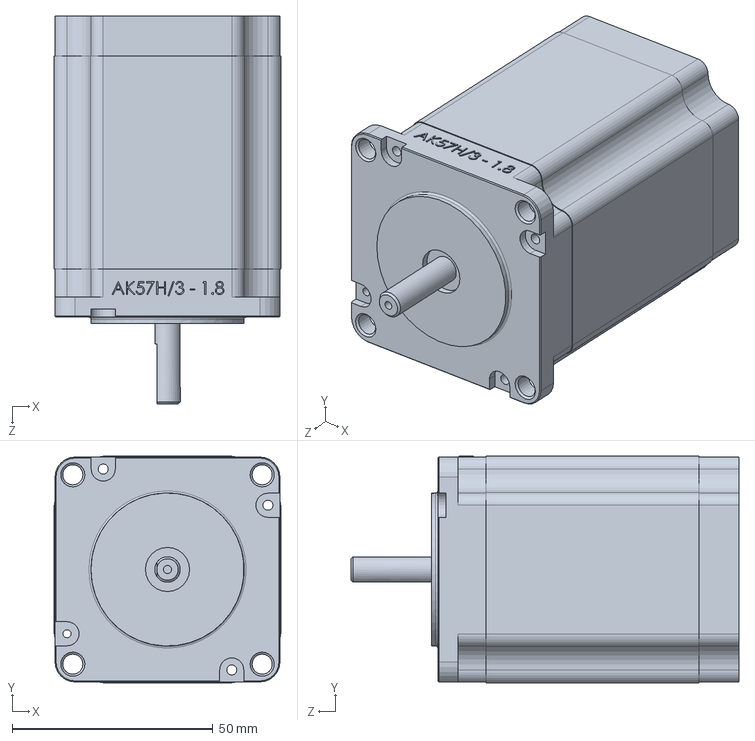
[picture p45: CAD file, 2025-04-27]
Backup-20241219-20250121T215628Z-001/Backup-20241219/LEMI_platform_v2024/Parts_new/BASE Deslocamento Raios gama/Motor/Tech Makers-3D-AK23-15F6FN1_8.sldprt
56.4 x 56.4 x 96.6 mm
