Marcus-Reiss/CAD-Backup-LEMI/Backup-20241219-20250121T215628Z-001/Backup-20241219/LEMI_platform_v2024/Parts_new/BASE Deslocamento Raios gama/parafuso mejorado.SLDPRT

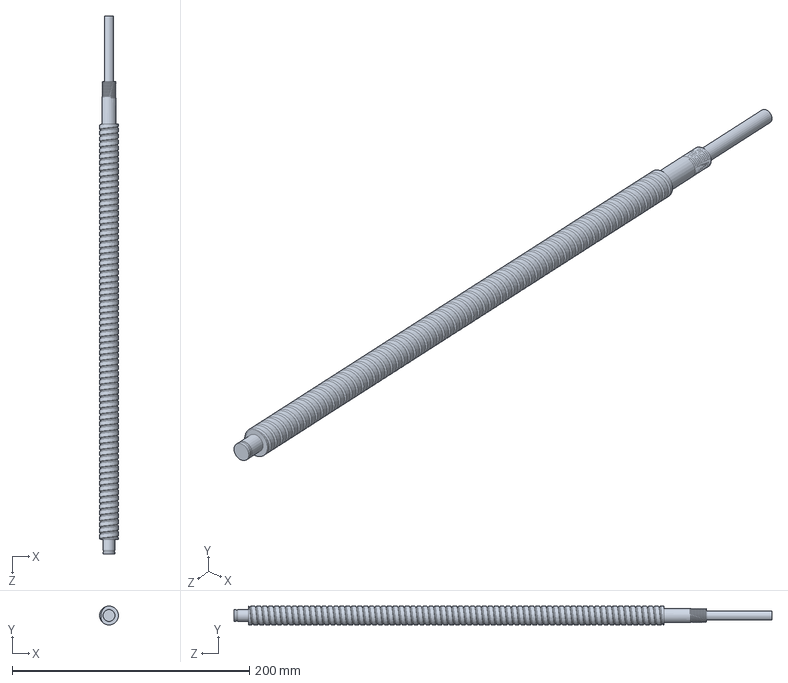
[picture p46: CAD file, 2025-04-27]
Backup-20241219-20250121T215628Z-001/Backup-20241219/LEMI_platform_v2024/Parts_new/BASE Deslocamento Raios gama/parafuso mejorado.SLDPRT
16.0 x 16.0 x 453.3 mm
