Marcus-Reiss/CAD-Backup-LEMI/Backup-20241219-20250121T215628Z-001/Backup-20241219/LEMI_platform_v2024/Parts_new/CAD Estrutura Raios Gama/chapa motor.SLDPRT

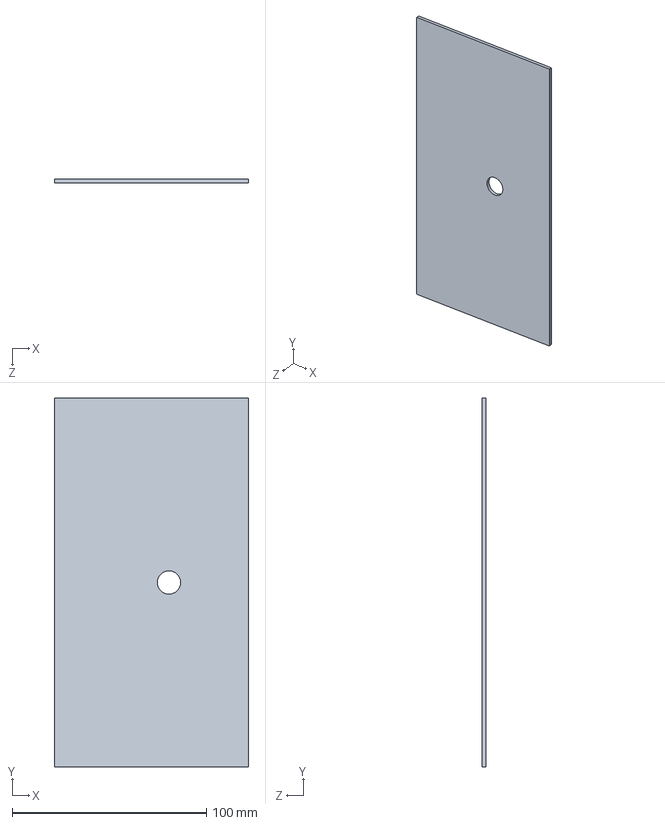
[picture p47: CAD file, 2025-04-27]
Backup-20241219-20250121T215628Z-001/Backup-20241219/LEMI_platform_v2024/Parts_new/CAD Estrutura Raios Gama/chapa motor.SLDPRT
100.0 x 190.0 x 2.00 mm
