Marcus-Reiss/CAD-Backup-LEMI/Backup-20241219-20250121T215628Z-001/Backup-20241219/LEMI_platform_v2024/Parts_new/CAD Estrutura Raios Gama/nema-23.snapshot.3/Stepper motor NEMA 23HS7430.SLDPRT

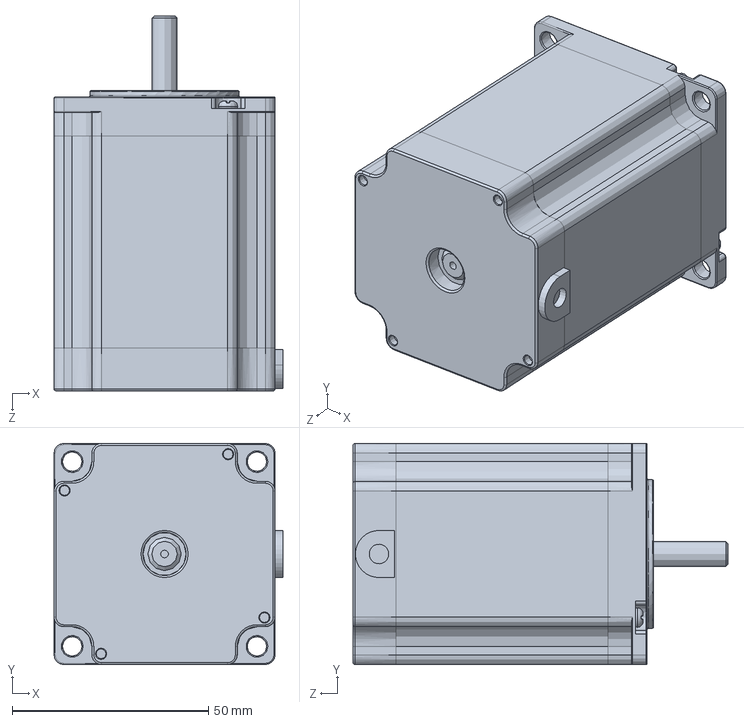
[picture p48: CAD file, 2025-04-27]
Backup-20241219-20250121T215628Z-001/Backup-20241219/LEMI_platform_v2024/Parts_new/CAD Estrutura Raios Gama/nema-23.snapshot.3/Stepper motor NEMA 23HS7430.SLDPRT
58.4 x 56.4 x 95.6 mm
