Marcus-Reiss/CAD-Backup-LEMI/Backup-20241219-20250121T215628Z-001/Backup-20241219/LEMI_platform_v2024/Parts_new/Compressor/porca_mangueira.SLDPRT

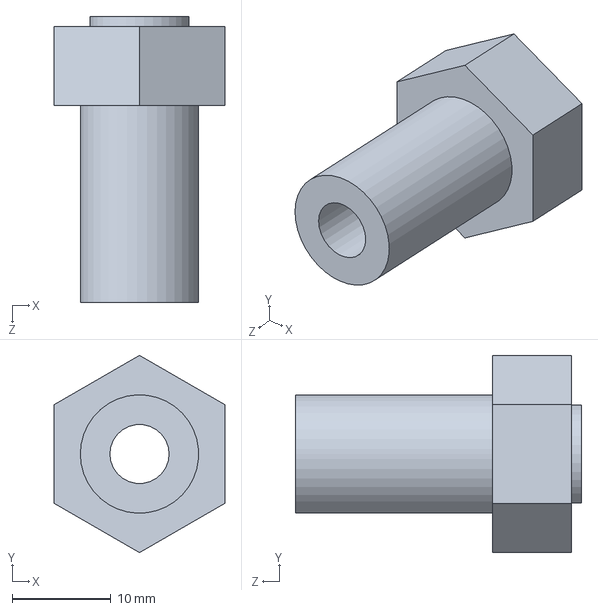
[picture p49: CAD file, 2025-04-27]
Backup-20241219-20250121T215628Z-001/Backup-20241219/LEMI_platform_v2024/Parts_new/Compressor/porca_mangueira.SLDPRT
17.3 x 20.0 x 29.0 mm
