Marcus-Reiss/CAD-Backup-LEMI/Backup-20241219-20250121T215628Z-001/Backup-20241219/LEMI_platform_v2024/Parts_new/Estantes/0001-2016-0000.STEP

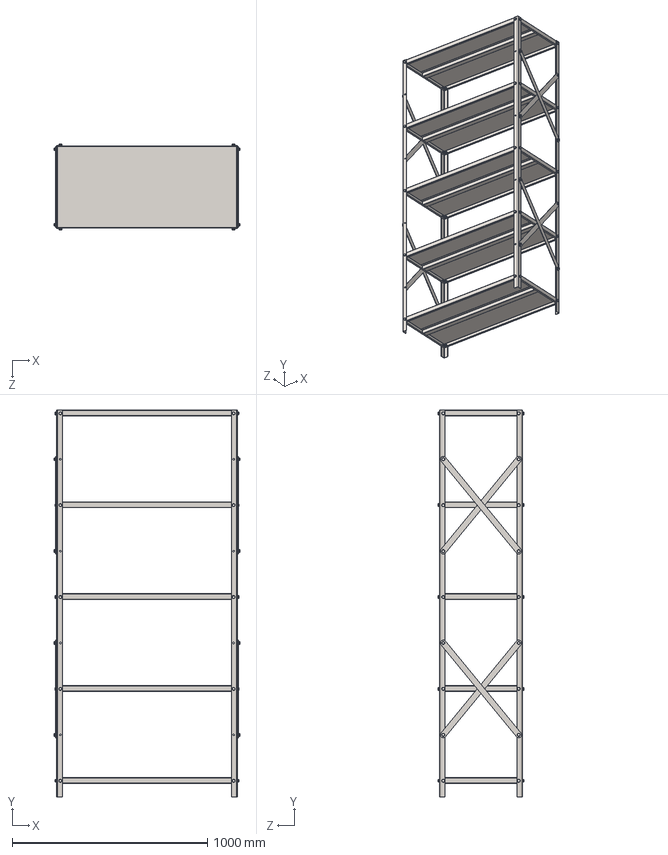
[picture p50: CAD file, 2025-04-27]
Backup-20241219-20250121T215628Z-001/Backup-20241219/LEMI_platform_v2024/Parts_new/Estantes/0001-2016-0000.STEP
950.4 x 1980.0 x 439.8 mm
Arruela lisa tipo A - DIN 125_Washer DIN 125 - A 8.4 x 56
Arruela de pressão - DIN 127_Spring washer DIN 128 - A8 x 56
Porca sextavada fina - DIN 439_Hexagon Thin Nut ISO 4035 - M8 - N x 56
Parafuso sextavado totalmente roscado - DIN 933_ISO 4017 - M8 x 16-N x 56
