Marcus-Reiss/CAD-Backup-LEMI/Backup-20241219-20250121T215628Z-001/Backup-20241219/LEMI_platform_v2024/Parts_new/LinhaSeletorLiquidos_Misturadores2024_vf.SLDPRT

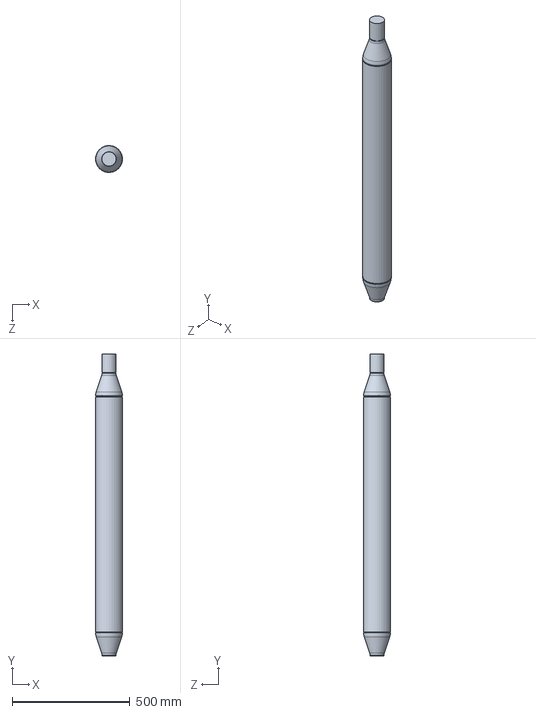
[picture p51: CAD file, 2025-04-27]
Backup-20241219-20250121T215628Z-001/Backup-20241219/LEMI_platform_v2024/Parts_new/LinhaSeletorLiquidos_Misturadores2024_vf.SLDPRT
114.0 x 1279.7 x 114.0 mm
