Marcus-Reiss/CAD-Backup-LEMI/Backup-20241219-20250121T215628Z-001/Backup-20241219/LEMI_platform_v2024/Parts_new/Nova estrutura raios gamma 2024/ALUMINIUM_PROFILE_20m x 20mm x 500mm.SLDPRT

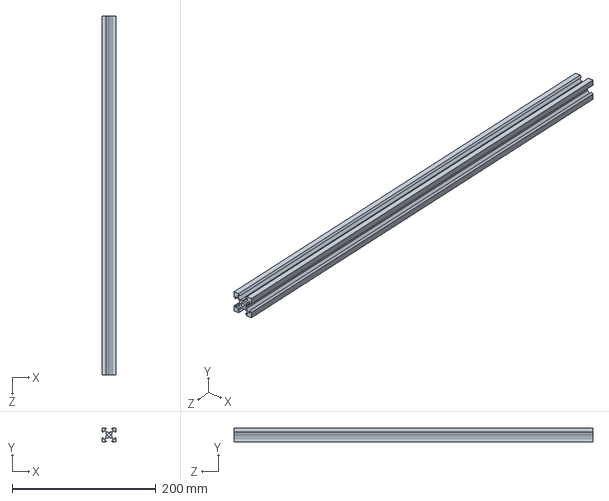
[picture p52: CAD file, 2025-04-27]
Backup-20241219-20250121T215628Z-001/Backup-20241219/LEMI_platform_v2024/Parts_new/Nova estrutura raios gamma 2024/ALUMINIUM_PROFILE_20m x 20mm x 500mm.SLDPRT
20.0 x 20.0 x 500.0 mm
