Marcus-Reiss/CAD-Backup-LEMI/Backup-20241219-20250121T215628Z-001/Backup-20241219/LEMI_platform_v2024/Parts_new/Sala-de-controle/m_sd-isn1575lcbsm55nn-desk-1.snapshot.4/M_SD-ISN1575LCBSM55NN.STEP

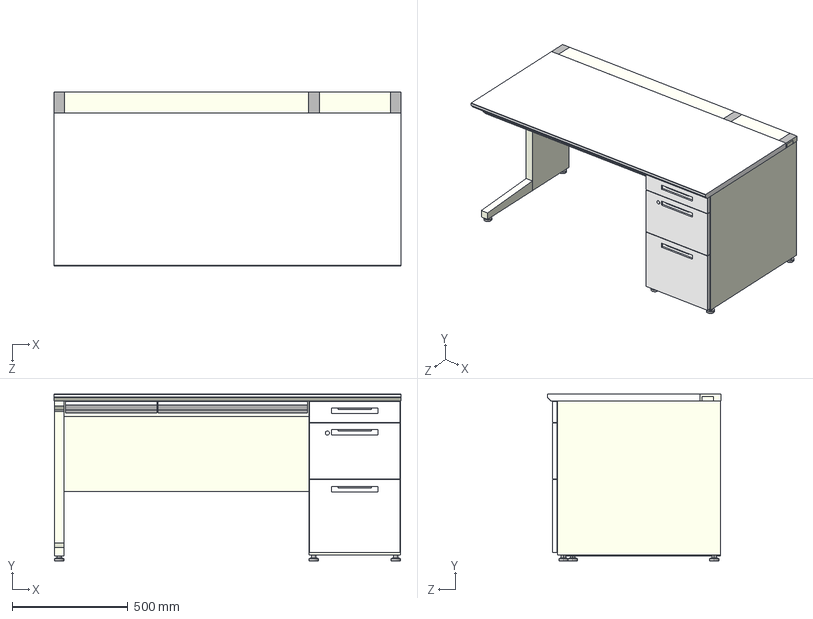
[picture p53: CAD file, 2025-04-27]
Backup-20241219-20250121T215628Z-001/Backup-20241219/LEMI_platform_v2024/Parts_new/Sala-de-controle/m_sd-isn1575lcbsm55nn-desk-1.snapshot.4/M_SD-ISN1575LCBSM55NN.STEP
1500.0 x 720.0 x 750.7 mm
