Marcus-Reiss/CAD-Backup-LEMI/Backup-20241219-20250121T215628Z-001/Backup-20241219/LEMI_platform_v2024/Parts_new/Sala-de-controle/manequim_sentado_1_76_m_11111111111.SLDPRT

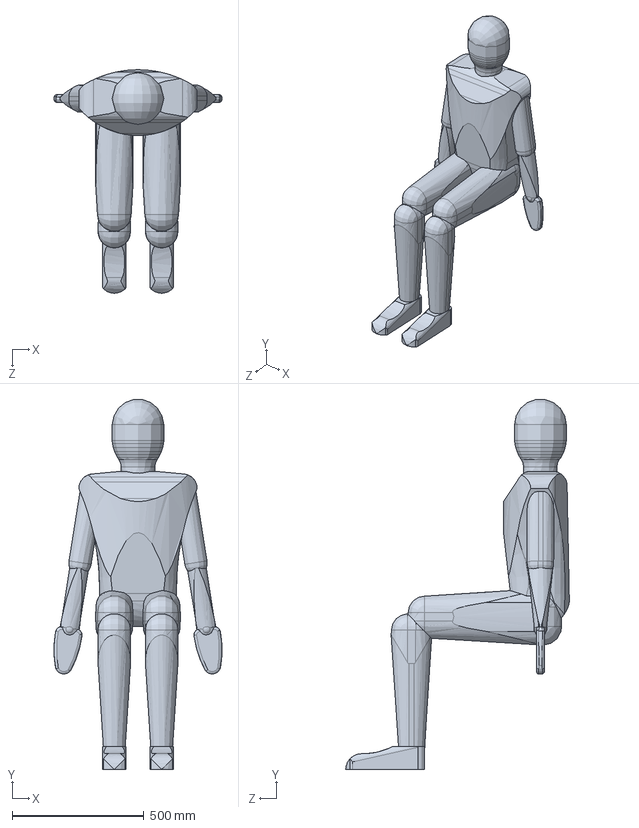
[picture p54: CAD file, 2025-04-27]
Backup-20241219-20250121T215628Z-001/Backup-20241219/LEMI_platform_v2024/Parts_new/Sala-de-controle/manequim_sentado_1_76_m_11111111111.SLDPRT
638.1 x 1406.0 x 849.5 mm
