Marcus-Reiss/CAD-Backup-LEMI/Backup-20241219-20250121T215628Z-001/Backup-20241219/LEMI_platform_v2024/Parts_new/Sala-de-controle/office-desk-45.snapshot.2/Plate.SLDPRT

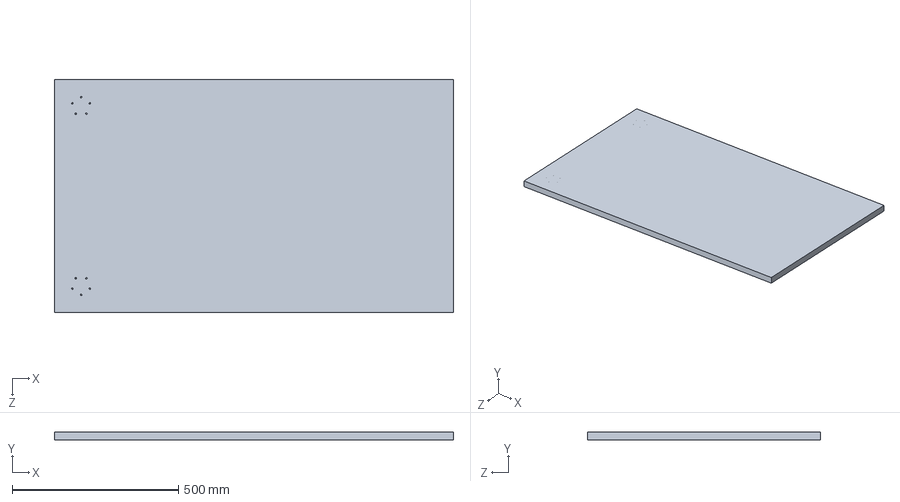
[picture p55: CAD file, 2025-04-27]
Backup-20241219-20250121T215628Z-001/Backup-20241219/LEMI_platform_v2024/Parts_new/Sala-de-controle/office-desk-45.snapshot.2/Plate.SLDPRT
1200.0 x 25.0 x 700.0 mm
