Marcus-Reiss/CAD-Backup-LEMI/Backup-20241219-20250121T215628Z-001/Backup-20241219/LEMI_platform_v2024/Parts_new/Valvulas e flanges/1pol_MGA/Valv 1 pol MGA.stp

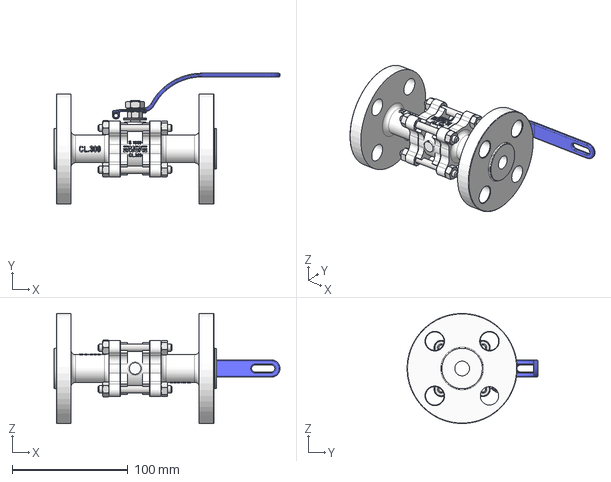
[picture p57: CAD file, 2025-04-27]
Backup-20241219-20250121T215628Z-001/Backup-20241219/LEMI_platform_v2024/Parts_new/Valvulas e flanges/1pol_MGA/Valv 1 pol MGA.stp
195.0 x 112.9 x 95.0 mm
