Marcus-Reiss/CAD-Backup-LEMI/Backup-20241219-20250121T215628Z-001/Backup-20241219/LEMI_platform_v2024/BancadaCafe_v2024.SLDASM

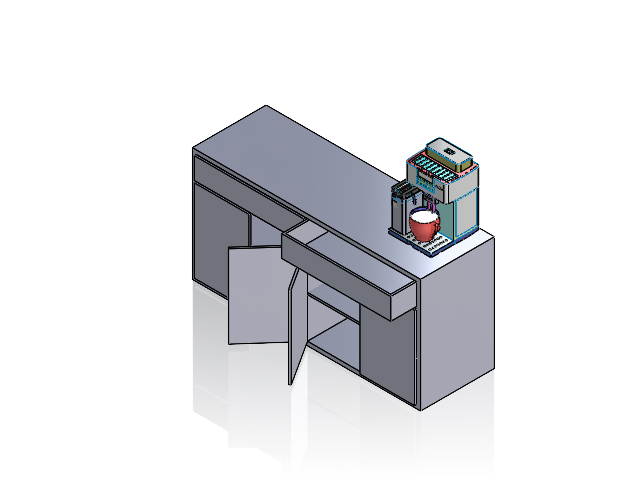
[picture p58: CAD file, 2025-04-27]
Backup-20241219-20250121T215628Z-001/Backup-20241219/LEMI_platform_v2024/BancadaCafe_v2024.SLDASM
Teste_v1^BancadaCafe_v2024
Separação_Opcao5^BancadaCafe_v2024
Porta_Opcao5^BancadaCafe_v2024 x 4
Gaveta_Opcao5^BancadaCafe_v2024 x 2
uper body.IGS
mid body.IGS
milk bottle.IGS
milk bottle part 2.IGS
milk straw.IGS
milk.IGS
Milk bottle nozel.IGS
cofee nozel.IGS
cofee mug.IGS
