Marcus-Reiss/CAD-Backup-LEMI/Backup_20250225/LEMI_platform_v2024/Desenhos-Misturadores-Simulacao_202410/Misturadores-LEMI_v0.SLDASM

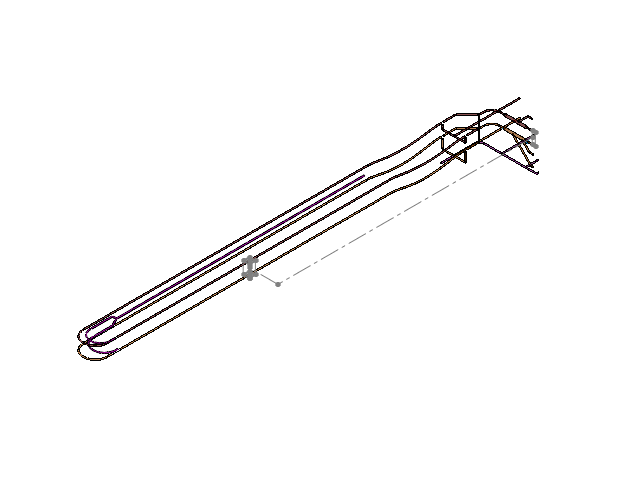
[picture p59: CAD file, 2025-04-27]
Backup_20250225/LEMI_platform_v2024/Desenhos-Misturadores-Simulacao_202410/Misturadores-LEMI_v0.SLDASM
Misturador-AltaP
Misturador-BaixaP
LinhaSeletorLiquidos
LinhaLiquidos_v2024
