Marcus-Reiss/CAD-Backup-LEMI/Backup_CAD-LEMI_20240524/LEMI_platform_v2024/CompressorAuxiliar/Transmissores/PT_piezo.SLDASM

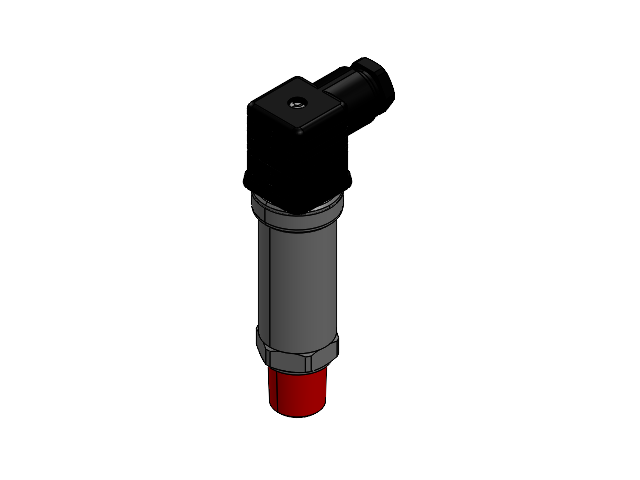
[picture p60: CAD file, 2025-04-27]
Backup_CAD-LEMI_20240524/LEMI_platform_v2024/CompressorAuxiliar/Transmissores/PT_piezo.SLDASM
7295-0.stp
7296-2-1.stp
PR3110EXxxxxAN_Solid-2.stp
