Marcus-Reiss/CAD-Backup-LEMI/Backup-20241219-20250121T215628Z-001/Backup-20241219/LEMI_platform_v2024/Calandras/ConjuntoCalandras_AntesMontagem.SLDASM

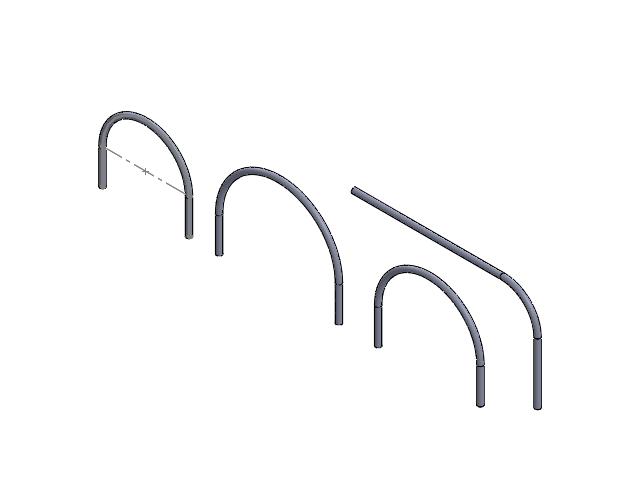
[picture p61: CAD file, 2025-04-27]
Backup-20241219-20250121T215628Z-001/Backup-20241219/LEMI_platform_v2024/Calandras/ConjuntoCalandras_AntesMontagem.SLDASM
LinhaConexao_Liquido-Rosa-com-AltaP-Vermelha^ConjuntoCalandras_AntesMontagem
LinhaBaixaP-Laranja^ConjuntoCalandras_AntesMontagem
LinhaConexao_Liquido-Rosa-com-BaixaP-Laranja^ConjuntoCalandras_AntesMontagem
LinhaTransmissao_Curva90_Liquidos-Rosa
