Marcus-Reiss/CAD-Backup-LEMI/(list of files, cad)

Other CAD files:
Backup-20241219-20250121T215628Z-001/Backup-20241219/LEMI_platform_v2024/Engetank_2024/TAMPO ASME 2x1 1000MM_TAMPO 1000X9,50-0.STEP.SLDPRT
Backup_20250225/LEMI_platform_v2024/Compressor-MarcusVinicius/Compressor-Auxiliar.SLDASM
Backup-20241219-20250121T215628Z-001/Backup-20241219/LEMI_platform_v2024/Parts_new/CAD Estrutura Raios Gama/THK_BNK140825RRG0671LC5Y31750/SOLIDWORKS/BNK1408_2_5RRG0_671LC5Y_317_50_.sldasm
Backup-20241219-20250121T215628Z-001/Backup-20241219/LEMI_platform_v2024/Parts_new/Valvulas e flanges/Retencao/SEKISUI-CheckValve-1pol/SOLIDWORKS/SCV25 (V).sldasm
Backup_20250225/LEMI_platform_v2024/Parts_new/CAD Estrutura Raios Gama/THK_BNK140825RRG0671LC5Y31750/SOLIDWORKS/BNK1408_2_5RRG0_671LC5Y_317_50_.sldasm
Backup_CAD-LEMI_20240524/LEMI_platform_v2024/Parts_new/CAD Estrutura Raios Gama/THK_BNK140825RRG0671LC5Y31750/SOLIDWORKS/BNK1408_2_5RRG0_671LC5Y_317_50_.sldasm
Backup-20241219-20250121T215628Z-001/Backup-20241219/LEMI_platform_v2024/Engetank_2024/TAMPO ASME 2x1 1000MM_TAMPO 1000X9,50.STEP.SLDPRT
Backup-20241219-20250121T215628Z-001/Backup-20241219/LEMI_platform_v2024/Parts_new/CAD Estrutura Raios Gama/guia/Montagem Guia 2.SLDASM
Backup-20241219-20250121T215628Z-001/Backup-20241219/LEMI_platform_v2024/Parts_new/Valvulas e flanges/Valvulas-Globo/valvs2/SOLIDWORKS/DN50/BOA-CVP H DN 50 PN 16 300B72A.sldasm
Backup_20250225/LEMI_platform_v2024/Parts_new/Valvulas e flanges/Retencao/SEKISUI-CheckValve-1pol/SOLIDWORKS/SCV25 (V).sldasm
Backup_CAD-LEMI_20240524/LEMI_platform_v2024/Parts_new/CAD Estrutura Raios Gama/guia/Montagem Guia 2.SLDASM
Backup_CAD-LEMI_20240524/LEMI_platform_v2024/Parts_new/TelescopicRail/HVC058-300.sldasm
Backup-20241219-20250121T215628Z-001/Backup-20241219/LEMI_platform_v2024/Mapa-Misturadores_LEMI-v2024/Mapa-Misturadores_LEMI-v2024.SLDASM
Backup-20241219-20250121T215628Z-001/Backup-20241219/LEMI_platform_v2024/Parts_new/TelescopicRail/HVC058-300.sldasm
Backup_20250225/LEMI_platform_v2024/Parts_new/TelescopicRail/HVC058-300.sldasm
Backup_20250225/LEMI_platform_v2024/Parts_new/CAD Estrutura Raios Gama/guia/Montagem Guia 2.SLDASM
Backup_20250225/LEMI_platform_v2024/Parts_new/Valvulas e flanges/Valvulas-Globo/valvs1/SOLIDWORKS/BOA-CVP H DN 25 PN 16 300B72A.sldasm
Backup-20241219-20250121T215628Z-001/Backup-20241219/LEMI_platform_v2024/Parts_new/Valvulas e flanges/Valvulas-Globo/valvs1/SOLIDWORKS/BOA-CVP H DN 25 PN 16 300B72A.sldasm
Backup_20250225/LEMI_platform_v2024/Parts_new/Valvulas e flanges/Valvulas-Globo/valvs2/SOLIDWORKS/DN50/BOA-CVP H DN 50 PN 16 300B72A.sldasm
Backup_20250225/LEMI_platform_v2024/Mapa-Misturadores_LEMI-v2024/Mapa-Misturadores_LEMI-v2024.SLDASM
Backup-20241219-20250121T215628Z-001/Backup-20241219/LEMI_platform_v2024/Engetank_2024/BV #16,0mm x TP #22,0mm.STEP.SLDASM
Backup-20241219-20250121T215628Z-001/Backup-20241219/LEMI_platform_v2024/Parts_new/Compressor-Auxiliar-v2.SLDASM
Backup_20250225/LEMI_platform_v2024/Engetank_2024/TAMPO ASME 2x1 1000MM_TAMPO 1000X9,50.STEP.SLDPRT
Backup_20250225/LEMI_platform_v2024/Engetank_2024/TAMPO ASME 2x1 1000MM_TAMPO 1000X9,50-0.STEP.SLDPRT
Backup_20250225/LEMI_platform_v2024/Engetank_2024/BV #16,0mm x TP #22,0mm.STEP.SLDASM
Backup-20241219-20250121T215628Z-001/Backup-20241219/LEMI_platform_v2024/Parts_new/Compressor-Auxiliar.SLDASM
Backup-20241219-20250121T215628Z-001/Backup-20241219/LEMI_platform_v2024/Desenhos-Misturadores-Simulacao_202410/LinhaSeletorLiquidos.SLDPRT
Backup-20241219-20250121T215628Z-001/Backup-20241219/LEMI_platform_v2024/Mapa-Misturadores_LEMI-v2024/HighPressure-Setup4.SLDPRT
Backup-20241219-20250121T215628Z-001/Backup-20241219/LEMI_platform_v2024/Parts_new/CAD Estrutura Raios Gama/THK_BNK14043RRG0280LC5Y1155/SOLIDWORKS/BNK1404_3RRG0_280LC5Y_115_5__3.sldprt
Backup-20241219-20250121T215628Z-001/Backup-20241219/LEMI_platform_v2024/Parts_new/CAD Estrutura Raios Gama/THK_BNK140825RRG0671LC5Y31750/SOLIDWORKS/BNK1408_2_5RRG0_671LC5Y_317_50__3.sldprt
Backup-20241219-20250121T215628Z-001/Backup-20241219/LEMI_platform_v2024/Parts_new/CAD Estrutura Raios Gama/THK_WTF20402ZZ7655LTH1K600300KFK15FF150/SOLIDWORKS/WTF2040_2ZZ_765_5LT_H1K_600300KFK_15FF_1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
Backup-20241219-20250121T215628Z-001/Backup-20241219/LEMI_platform_v2024/Parts_new/telescopic-drawers-slide-2.snapshot.1/2831110/3832TR Touch Release.sldprt
Backup-20241219-20250121T215628Z-001/Backup-20241219/LEMI_platform_v2024/Parts_new/TelescopicRail/HVC-58-300-300-g2.sldprt
Backup-20241219-20250121T215628Z-001/Backup-20241219/LEMI_platform_v2024/Calandras/ConjuntoCalandras_AntesMontagem - LinhaBaixaP-Laranja^ConjuntoCalandras_AntesMontagem-1.STL
Backup-20241219-20250121T215628Z-001/Backup-20241219/LEMI_platform_v2024/Calandras/ConjuntoCalandras_AntesMontagem - LinhaConexao_Liquido-Rosa-com-AltaP-Vermelha^ConjuntoCalandras_AntesMontagem-1.STL
Backup-20241219-20250121T215628Z-001/Backup-20241219/LEMI_platform_v2024/Calandras/ConjuntoCalandras_AntesMontagem - LinhaConexao_Liquido-Rosa-com-BaixaP-Laranja^ConjuntoCalandras_AntesMontagem-1.STL
Backup-20241219-20250121T215628Z-001/Backup-20241219/LEMI_platform_v2024/Calandras/ConjuntoCalandras_AntesMontagem - LinhaTransmissao_Curva90_Liquidos-Rosa-1.STL
Backup-20241219-20250121T215628Z-001/Backup-20241219/LEMI_platform_v2024/Calandras/ConjuntoCalandras_AntesMontagem_Parasolid.x_t
Backup-20241219-20250121T215628Z-001/Backup-20241219/LEMI_platform_v2024/Calandras/LinhaAltaP_LinhaVermelha.x_t
Backup-20241219-20250121T215628Z-001/Backup-20241219/LEMI_platform_v2024/Calandras/LinhaBaixaP_LinhaLaranja.SLDPRT
Backup-20241219-20250121T215628Z-001/Backup-20241219/LEMI_platform_v2024/Calandras/LinhaBaixaP_LinhaLaranja.x_t
Backup-20241219-20250121T215628Z-001/Backup-20241219/LEMI_platform_v2024/Calandras/LinhaTransmissao_Curva90_Liquidos-Rosa.SLDPRT
Backup-20241219-20250121T215628Z-001/Backup-20241219/LEMI_platform_v2024/Calandras/NovasCalandras_Junho24/Calandra_1.SLDPRT
Backup-20241219-20250121T215628Z-001/Backup-20241219/LEMI_platform_v2024/Calandras/NovasCalandras_Junho24/Calandra_1^Assem1.SLDPRT
Backup-20241219-20250121T215628Z-001/Backup-20241219/LEMI_platform_v2024/Calandras/NovasCalandras_Junho24/Calandra_2^Assem1.SLDPRT
Backup-20241219-20250121T215628Z-001/Backup-20241219/LEMI_platform_v2024/Calandras/NovasCalandras_Junho24/Calandra_Juncao_CorteLaser.x_t
Backup-20241219-20250121T215628Z-001/Backup-20241219/LEMI_platform_v2024/Calandras/NovasCalandras_Junho24/Calandra_LinhaBaixaP_Junho2024.x_t
Backup-20241219-20250121T215628Z-001/Backup-20241219/LEMI_platform_v2024/Calandras/NovasCalandras_Junho24/Calandras.x_t
Backup-20241219-20250121T215628Z-001/Backup-20241219/LEMI_platform_v2024/Calandras/NovasCalandras_Junho24/Part1.SLDPRT
Backup-20241219-20250121T215628Z-001/Backup-20241219/LEMI_platform_v2024/Chapa45/Chapa45_v0_A3.SLDDRW
Backup-20241219-20250121T215628Z-001/Backup-20241219/LEMI_platform_v2024/Chapa45/Chapa45_v0_Parasolid3D.x_t
Backup-20241219-20250121T215628Z-001/Backup-20241219/LEMI_platform_v2024/Chapa45/Chapa45_v0_SOLIDWORKS.SLDDRW
Backup-20241219-20250121T215628Z-001/Backup-20241219/LEMI_platform_v2024/Conjunto-Abraçadeiras-Aço-1020/Abraçadeiras-Aço1020.SLDDRW
Backup-20241219-20250121T215628Z-001/Backup-20241219/LEMI_platform_v2024/Conjunto-Abraçadeiras-Aço-1020/Abraçadeiras-Aço1020_Dupla-1pol_v0.SLDDRW
Backup-20241219-20250121T215628Z-001/Backup-20241219/LEMI_platform_v2024/Conjunto-Abraçadeiras-Aço-1020/Abraçadeiras-Aço1020_Dupla-2pol_v0.SLDDRW
Backup-20241219-20250121T215628Z-001/Backup-20241219/LEMI_platform_v2024/Conjunto-Abraçadeiras-Aço-1020/Abraçadeiras-Aço1020_Individuais_v0.SLDDRW
Backup-20241219-20250121T215628Z-001/Backup-20241219/LEMI_platform_v2024/Conjunto-Abraçadeiras-Aço-1020/Dupla-2pol.SLDPRT
Backup-20241219-20250121T215628Z-001/Backup-20241219/LEMI_platform_v2024/Conjunto-Abraçadeiras-Aço-1020/Individual-1pol.SLDPRT
Backup-20241219-20250121T215628Z-001/Backup-20241219/LEMI_platform_v2024/Conjunto-Abraçadeiras-Aço-1020/Individual-2pol.SLDDRW
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
