Marcus-Reiss/CAD-Backup-LEMI/Backup_20250225/LEMI_platform_v2024/Mapa-Misturadores_LEMI-v2024/LowPressure_Setup1_XYZcoordinates.xlsx

X | Y | Z
2400 | 1025 | -19080
2050 | 1025 | -19080
1680 | 1025 | -19080
2400 | 662 | -19080
2063.710678 | 662 | -19080
2055.348878 | 662.7041554 | -19080
2049.138564 | 664.1705791 | -19080
2044.576507 | 665.8060234 | -19080
2038.765909 | 668.6668892 | -19080
2033.093103 | 672.4707184 | -19080
2028.355339 | 676.6446609 | -19080
1854.17767 | 850.8223305 | -19080
2400 | 200 | -19080
1995.710678 | 200 | -19080
1989.309978 | 200.411382 | -19080
1982.849844 | 201.6823122 | -19080
1976.576507 | 203.8060234 | -19080
1969.571678 | 207.376618 | -19080
1964.70442 | 210.7748552 | -19080
1960.355339 | 214.6446609 | -19080
1555.17767 | 619.8223305 | -19080
1150 | 1025 | -19080
850 | 1025 | -19080
400 | 1025 | -19080
361.7516667 | 1025 | -19078.16713
329.31 | 1025 | -19073.70365
299.1008649 | 1025 | -19067.06506
272.7705464 | 1025 | -19059.2264
237.0742011 | 1025 | -19045.31518
205.1384679 | 1025 | -19029.32647
176.7808254 | 1025 | -19011.92349
148.97995 | 1025 | -18991.43046
117.1572875 | 1025 | -18962.84271
90.619203 | 1025 | -18933.54195
68.93283401 | 1025 | -18904.48726
52.62818123 | 1025 | -18878.32504
34.9677221 | 1025 | -18843.55866
19.30705697 | 1025 | -18802.77167
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
