Marcus-Reiss/CAD-Backup-LEMI/Backup_20250225/LEMI_platform_v2024/Parts_new/ConexaoValvulasAgulha_VSIDV-2025.pdf

E E

F F

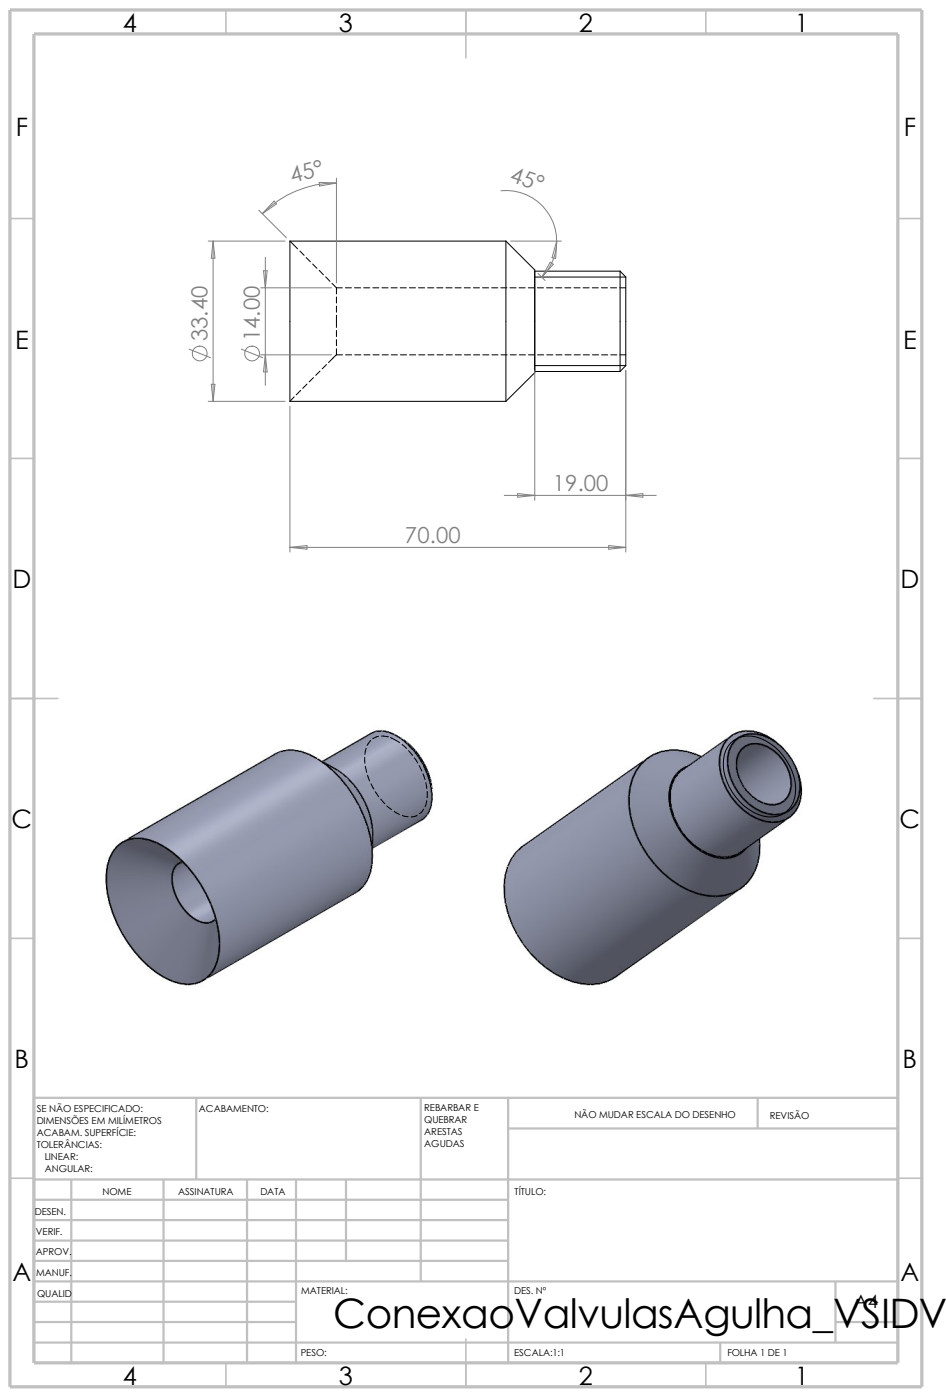
[picture p64: page 1]
DES. Nº; ESCALA:1:1; FOLHA 1 DE 1; PESO:; NÃO MUDAR ESCALA DO DESENHO; REVISÃO; MATERIAL:; QUALID; MANUF.; ACABAMENTO:; AGUDAS; REBARBAR E QUEBRAR ARESTAS; ConexaoValvulasAgulha_VSIDV-225

SE NÃO ESPECIFICADO:
DIMENSÕES EM MILÍMETROS
ACABAM. SUPERFÍCIE:
TOLERÂNCIAS:
LINEAR:
ANGULAR:

NOME | ASSINATURA | DATA | TÍTULO:

DESEN.
VERIF.
APROV.
