Marcus-Reiss/CAD-Backup-LEMI/Backup_20250225/LEMI_platform_v2024/Parts_new/ConexaoValvulasAgulha_VSIDV-2025_2.pdf

E E

F F

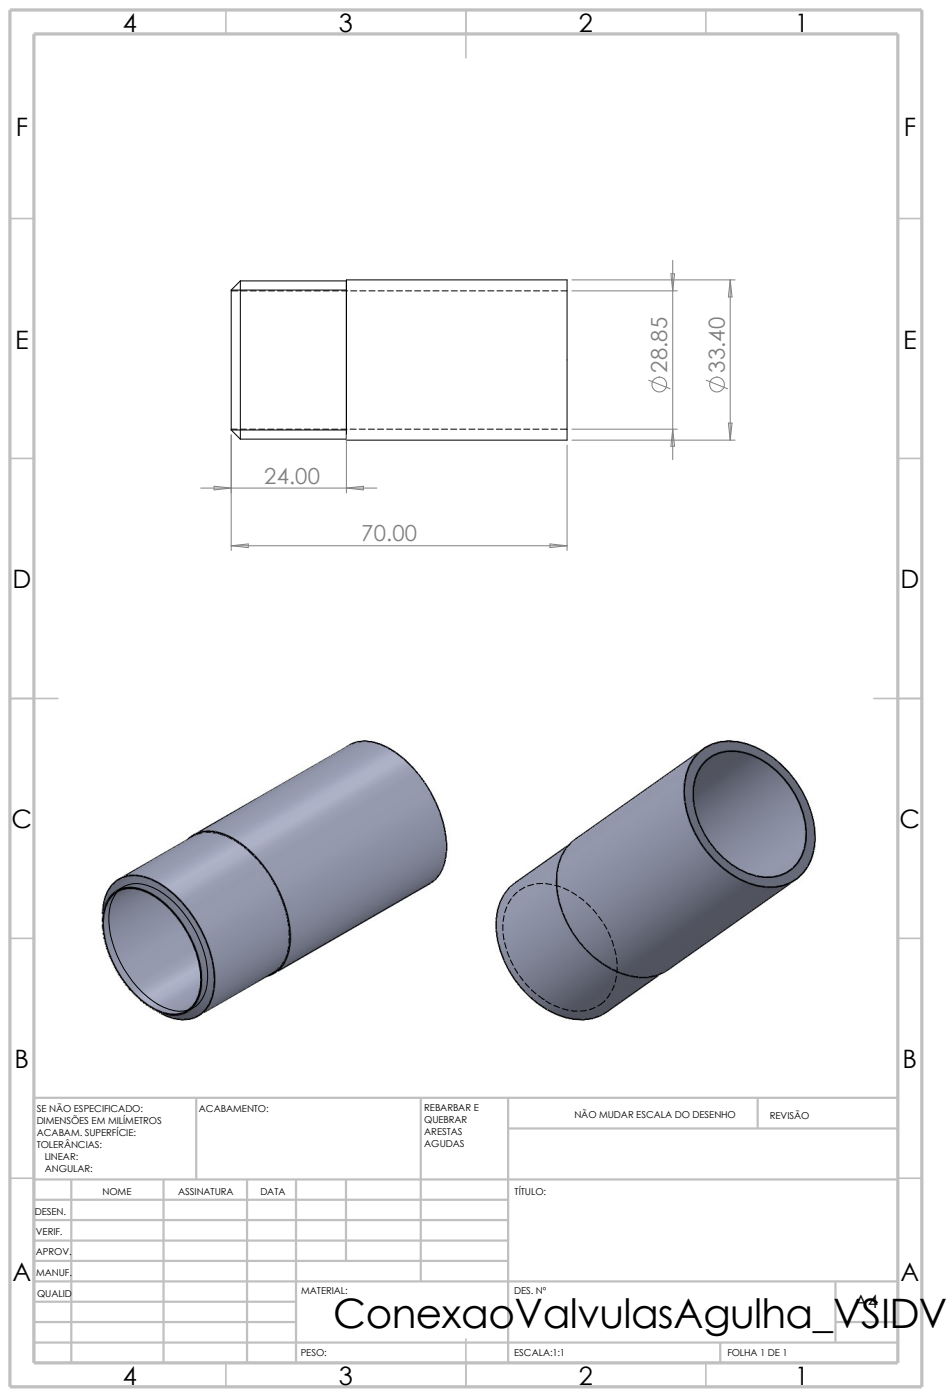
[picture p65: page 1]
FOLHA 1 DE 1; PESO:; ESCALA:1:1; DES. Nº; NÃO MUDAR ESCALA DO DESENHO; REVISÃO; MANUF.; QUALID; ACABAMENTO:; AGUDAS; MATERIAL:; REBARBAR E QUEBRAR ARESTAS; ConexaoValvulasAgulha_VSIDV-225 ²⁸.85

SE NÃO ESPECIFICADO:
DIMENSÕES EM MILÍMETROS
ACABAM. SUPERFÍCIE:
TOLERÂNCIAS:
LINEAR:
ANGULAR:

NOME | ASSINATURA | DATA | TÍTULO:

DESEN.
VERIF.
APROV.
