Marcus-Reiss/CAD-Backup-LEMI/Backup_20250225/LEMI_platform_v2024/Parts_new/Serpentina1pol_VSIDV-2025_vPDF.pdf

125.00

560.00 200.00

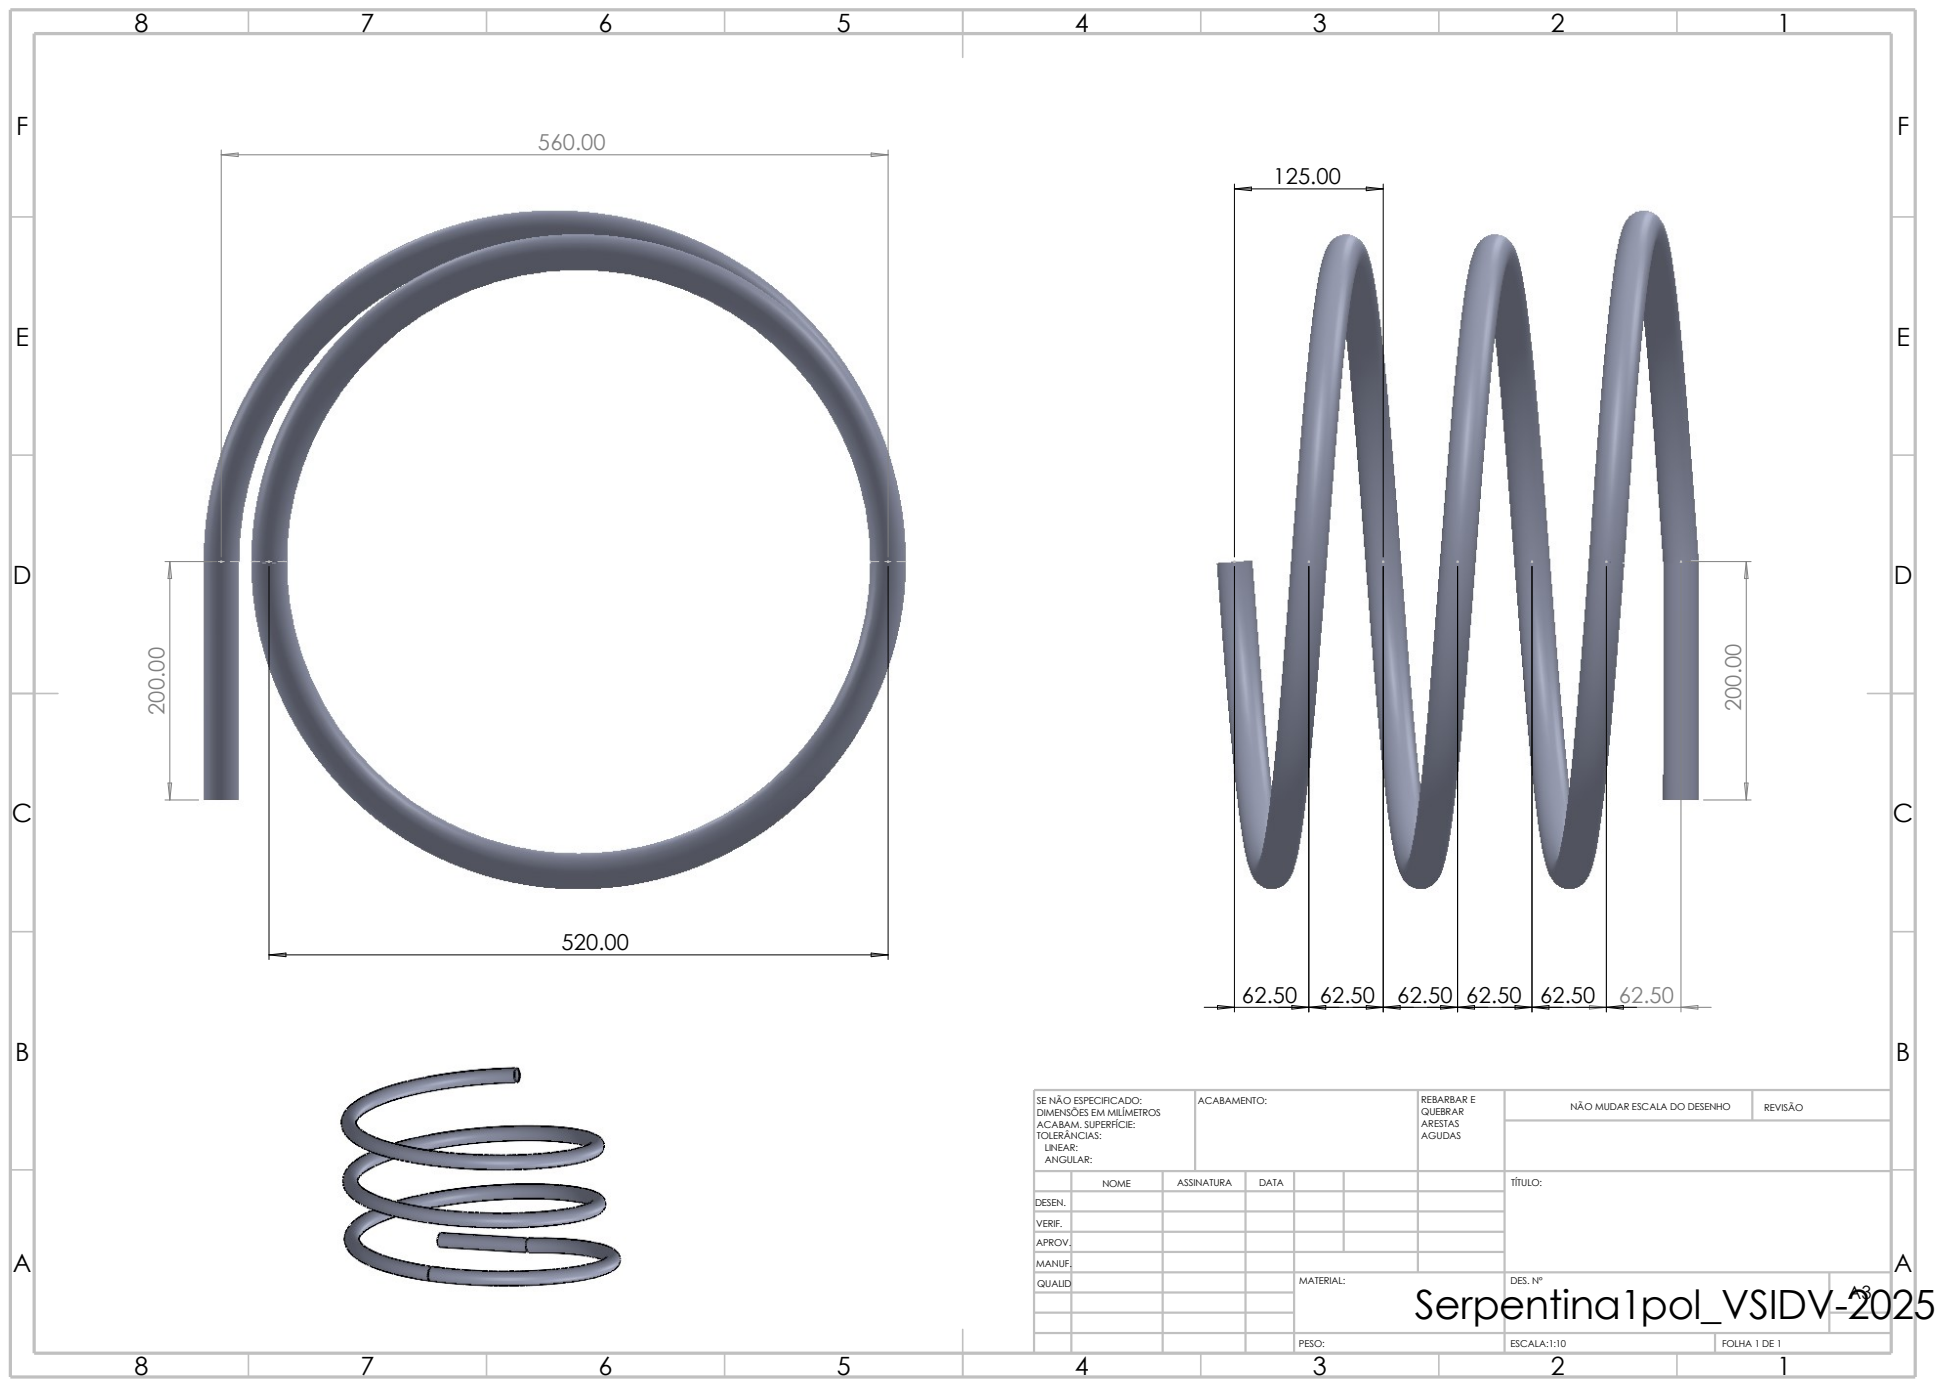
[picture p66: page 1]
ESCALA:1:10; FOLHA 1 DE 1; PESO:; NÃO MUDAR ESCALA DO DESENHO; REVISÃO; ACABAMENTO:; AGUDAS; REBARBAR E QUEBRAR ARESTAS; Serpentina1pol_VSIDV-2025

SE NÃO ESPECIFICADO:
DIMENSÕES EM MILÍMETROS
ACABAM. SUPERFÍCIE:
TOLERÂNCIAS:
LINEAR:
ANGULAR:

NOME | ASSINATURA | DATA | | | | TÍTULO:

DESEN.
VERIF.
APROV.

MANUF.
QUALID | | | | MATERIAL: | DES. Nº | A3
