Marcus-Reiss/CAD-Backup-LEMI/Backup_20250225/LEMI_platform_v2024/Parts_new/Serpentina1pol_VSIDV-2025_vPDF_partes.pdf

560.00 520.00

E E

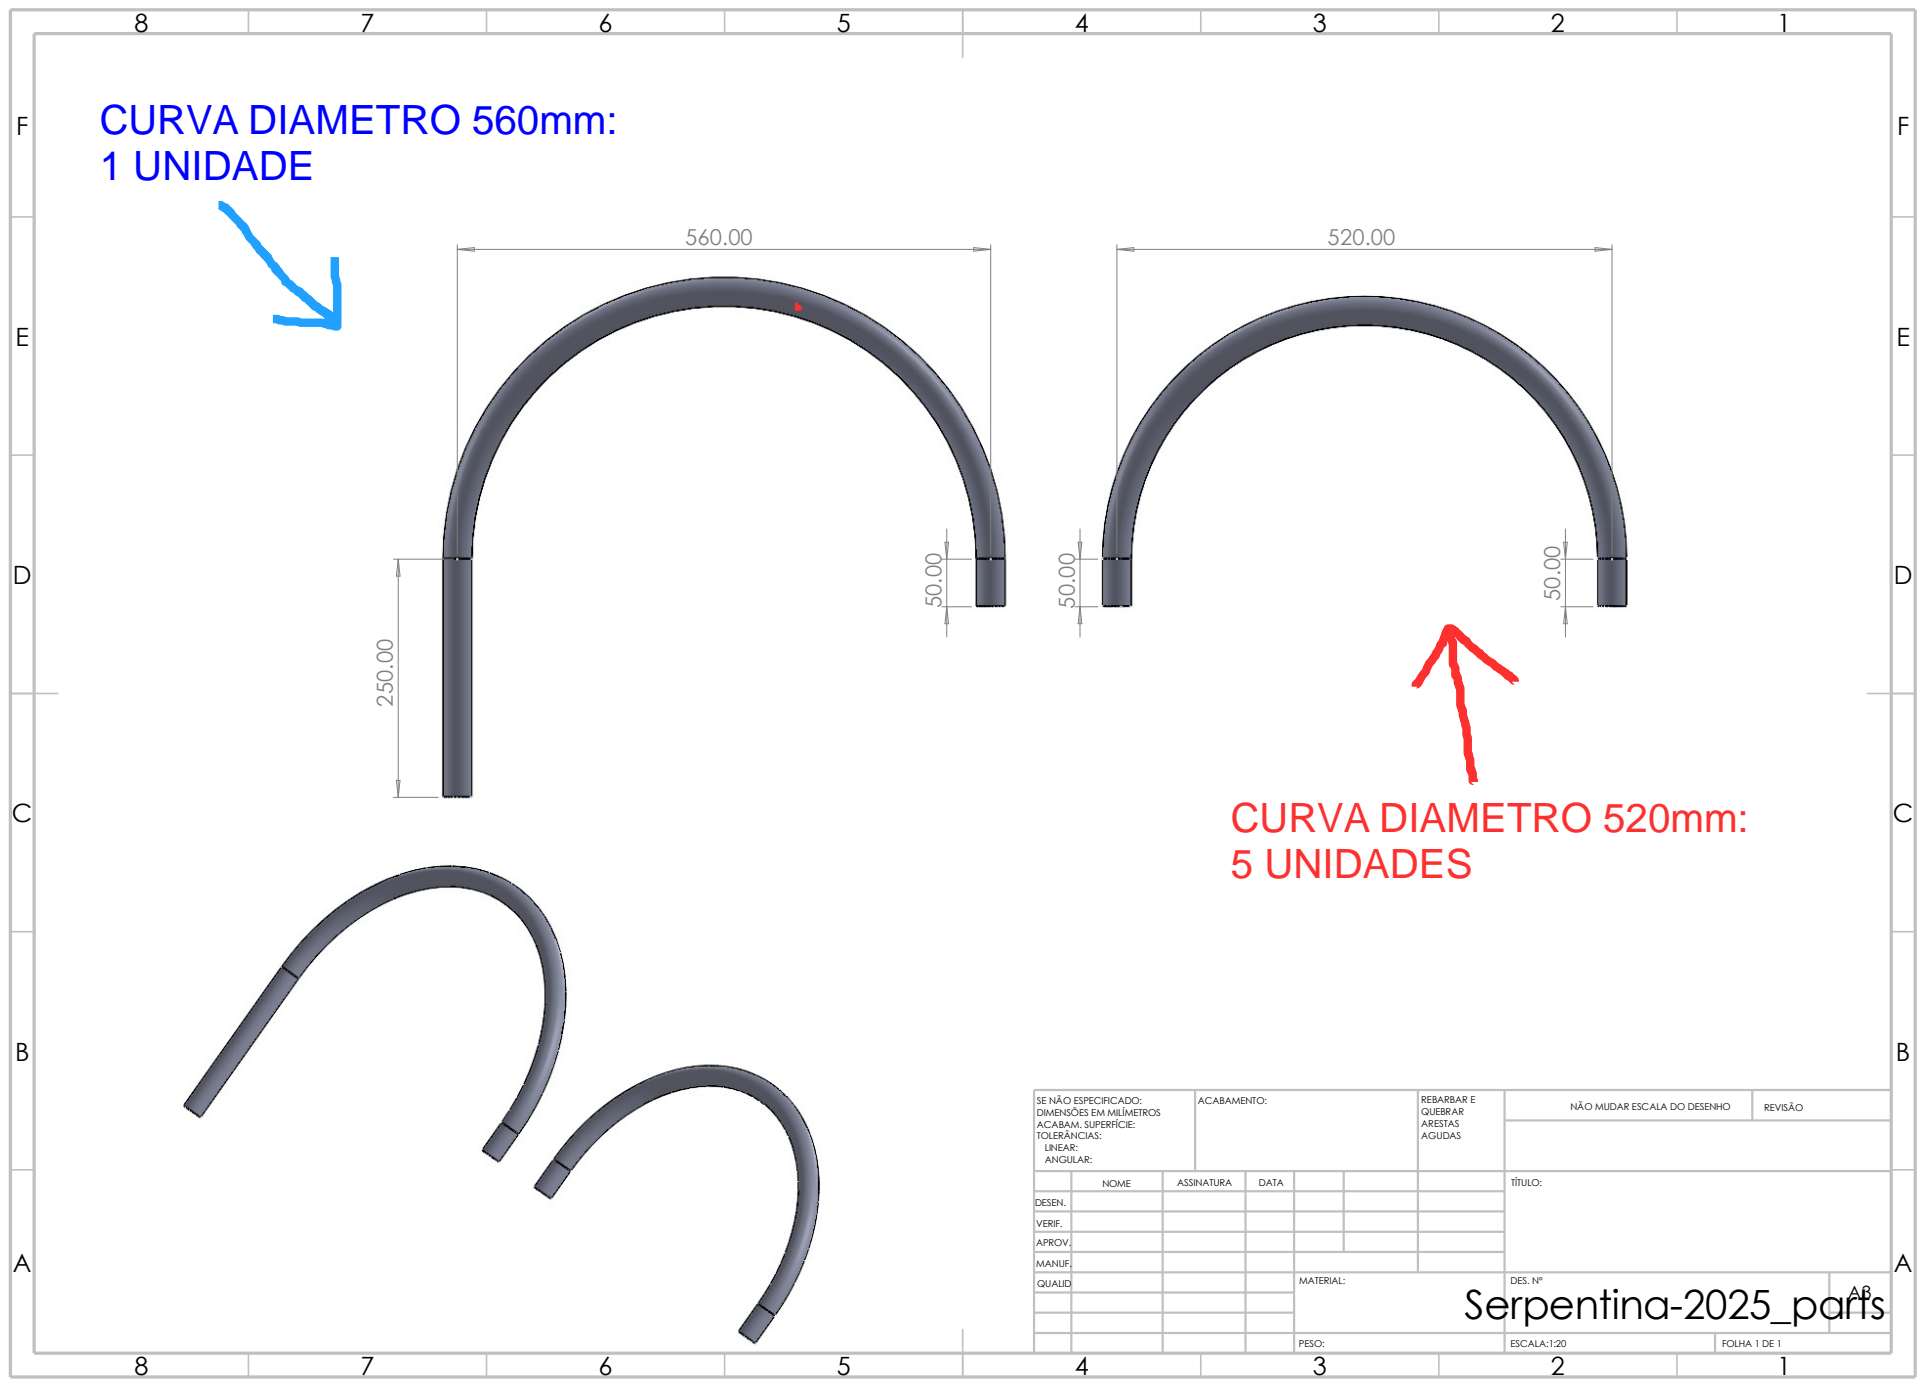
[picture p67: page 1]
PESO:; ESCALA:1:20; FOLHA 1 DE 1; NÃO MUDAR ESCALA DO DESENHO; REVISÃO SE NÃO ESPECIFICADO:; Serpentina-2025_parts ⁵⁰.00

DIMENSÕES EM MILÍMETROS ACABAM. SUPERFÍCIE: TOLERÂNCIAS: LINEAR: ANGULAR: | ACABAMENTO: | REBARBAR E QUEBRAR ARESTAS AGUDAS

NOME | ASSINATURA | DATA | | | | TÍTULO:

DESEN.
VERIF.
APROV.

MANUF.
QUALID | | | | MATERIAL: | DES. Nº | A3
