Marcus-Reiss/CAD-Backup-LEMI/Backup_20250225/LEMI_platform_v2024/Parts_new/Serpentina1pol_VSIDV-2025_vPDF_pt1.pdf

E E

F F

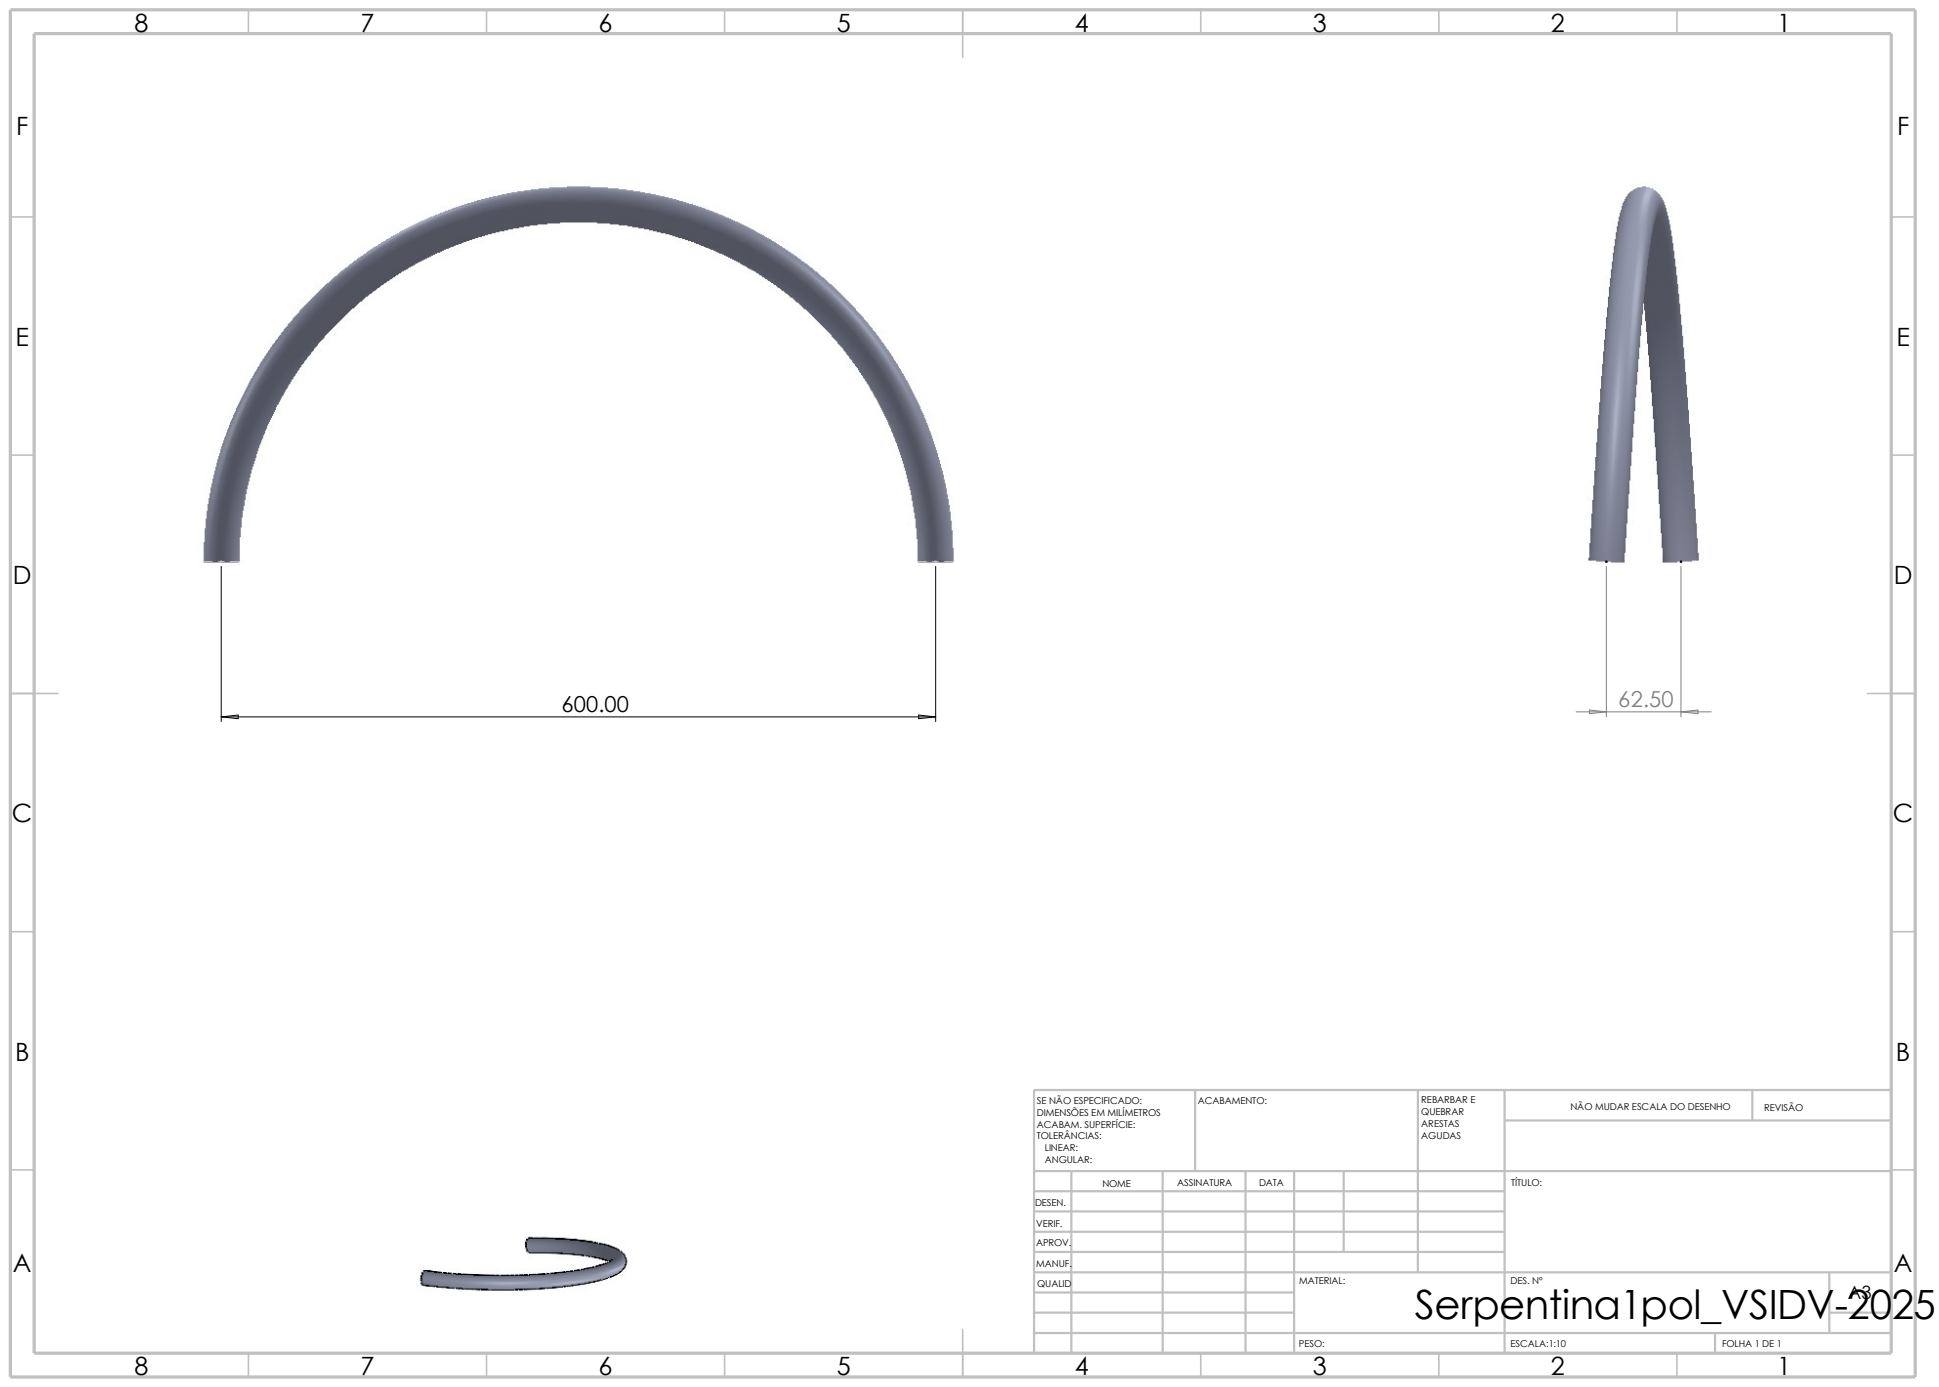
[picture p68: page 1]
REVISÃO; ESCALA:1:10; FOLHA 1 DE 1; PESO:; AGUDAS; ACABAMENTO:; REBARBAR E QUEBRAR ARESTAS; Serpentina1pol_VSIDV-2025

SE NÃO ESPECIFICADO:
DIMENSÕES EM MILÍMETROS
ACABAM. SUPERFÍCIE:
TOLERÂNCIAS:
LINEAR:
ANGULAR:

NÃO MUDAR ESCALA DO DESENHO

NOME | ASSINATURA | DATA | | | | TÍTULO:

DESEN.
VERIF.
APROV.

MANUF.
QUALID | | | | MATERIAL: | DES. Nº | A3
