Marcus-Reiss/CAD-Backup-LEMI/Backup_20250225/LEMI_platform_v2024/Parts_new/Serpentina1pol_VSIDV-2025_vPDF_pt2.pdf

560.00

125.00

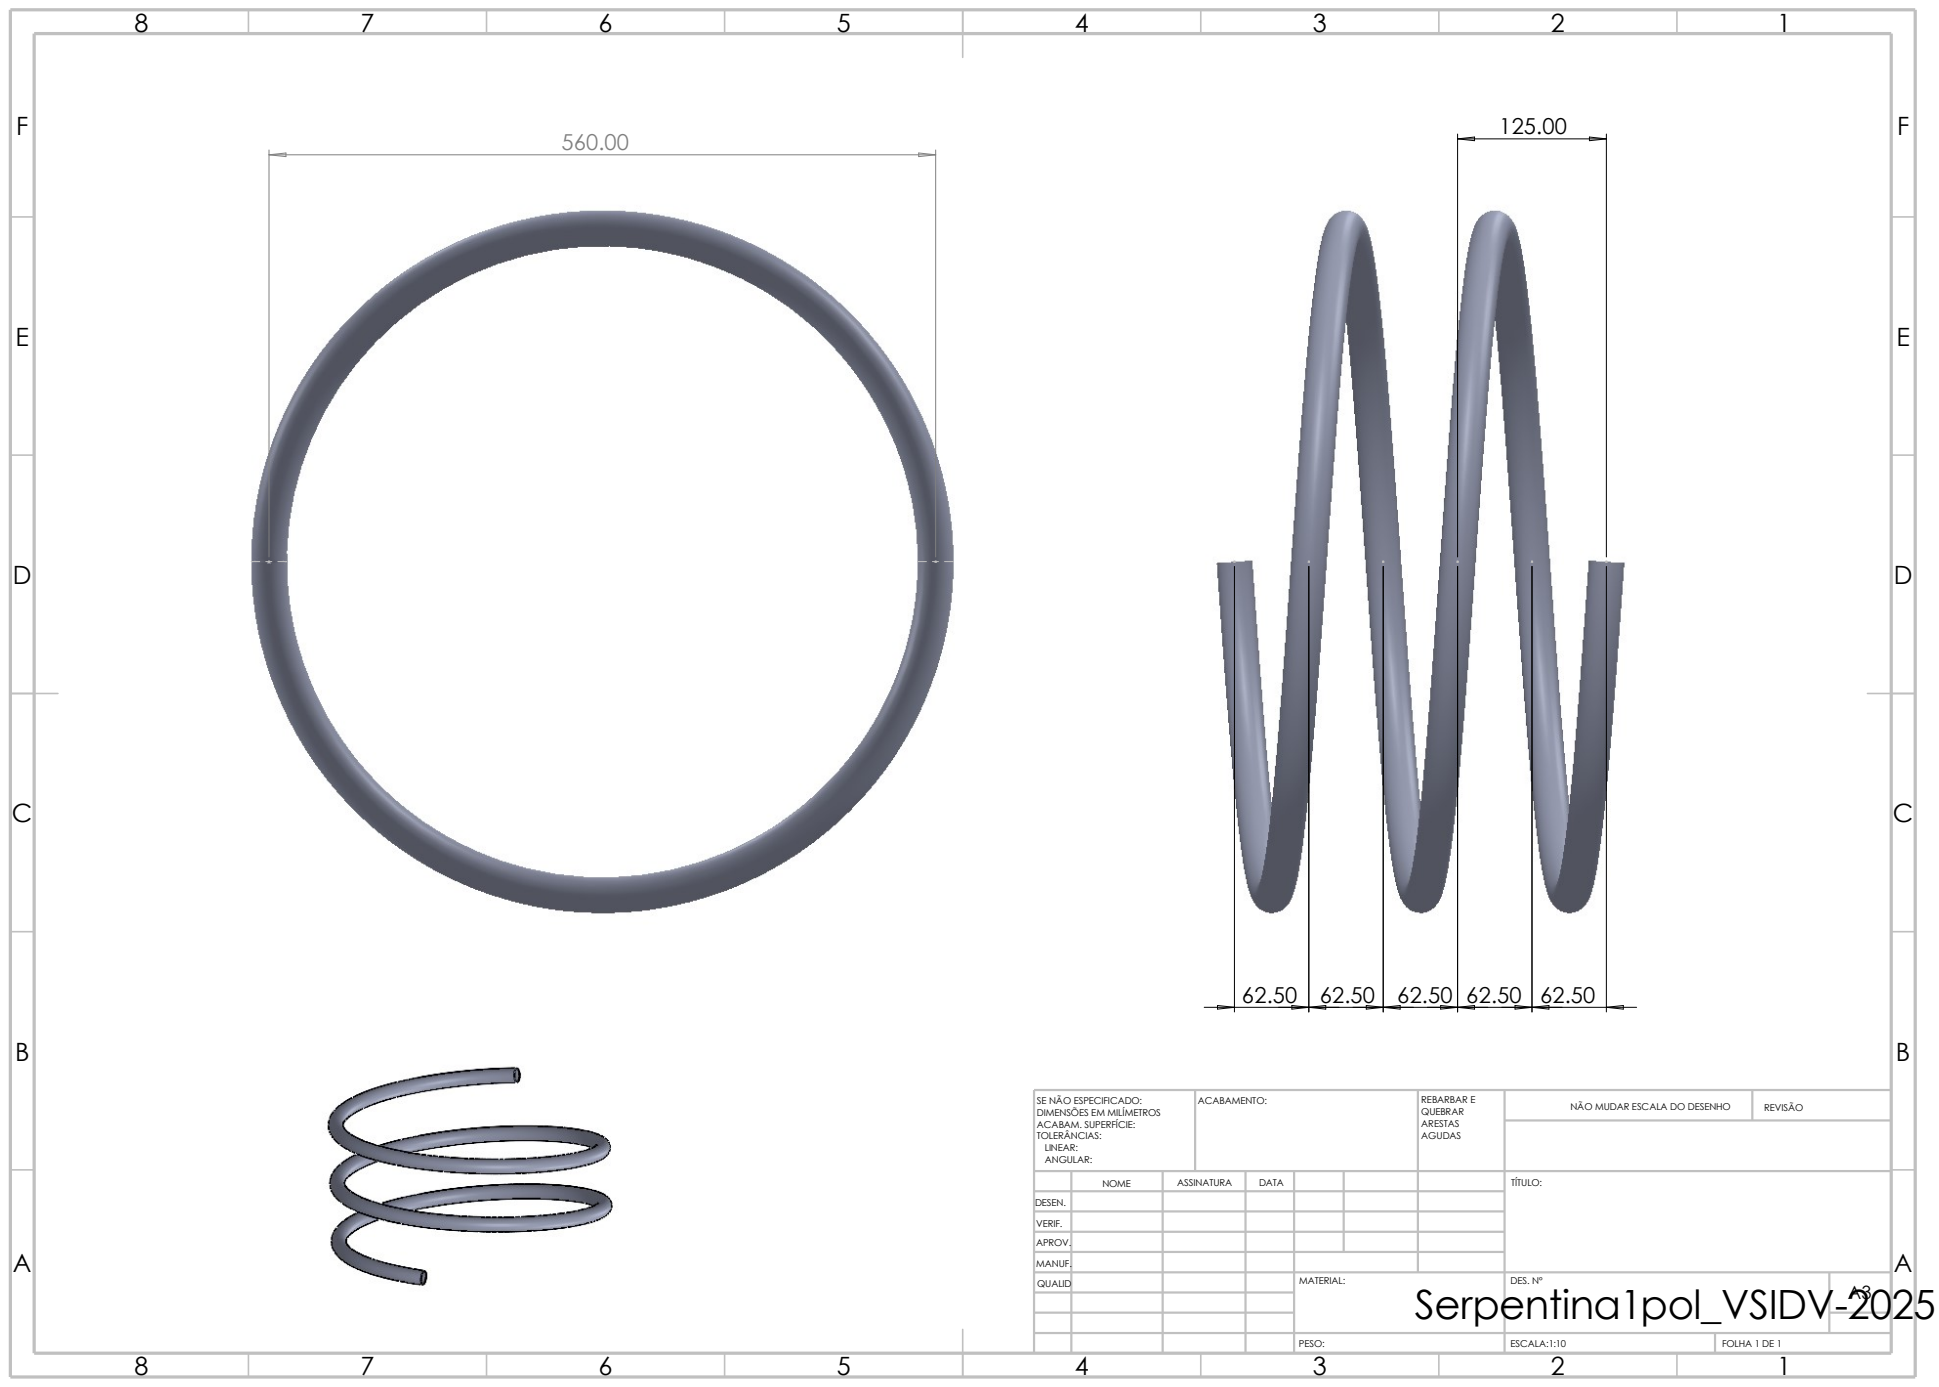
[picture p69: page 1]
NÃO MUDAR ESCALA DO DESENHO; REVISÃO; ESCALA:1:10; FOLHA 1 DE 1; PESO:; AGUDAS; SE NÃO ESPECIFICADO:; ACABAMENTO:; REBARBAR E QUEBRAR ARESTAS; Serpentina1pol_VSIDV-2025

DIMENSÕES EM MILÍMETROS
ACABAM. SUPERFÍCIE:
TOLERÂNCIAS:
LINEAR:
ANGULAR:

NOME | ASSINATURA | DATA | | | | TÍTULO:

DESEN.
VERIF.
APROV.

MANUF.
QUALID | | | | MATERIAL: | DES. Nº | A3
