Marcus-Reiss/CAD-Backup-LEMI/Backup_20250225/LEMI_platform_v2024/SuporteDP/Redutor_1.5pol-0.25pol_v0.pdf

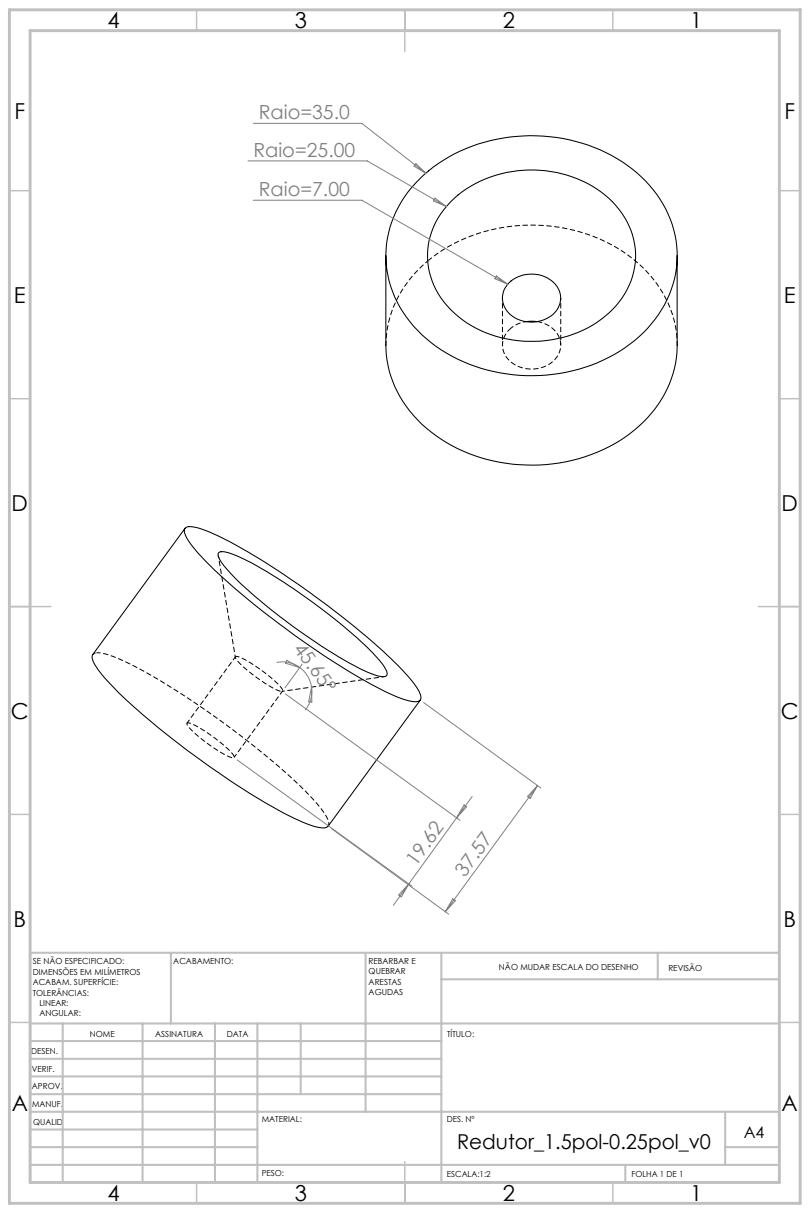
[picture p70: page 1]
ACABAMENTO:; REBARBAR E; NÃO MUDAR ESCALA DO DESENHO; REVISÃO; ESCALA:1:2; FOLHA 1 DE 1

SE NÃO ESPECIFICADO:
DIMENSÕES EM MILÍMETROS
ACABAM. SUPERFÍCIE:
TOLERÂNCIAS:
LINEAR:
ANGULAR:

NOME | ASSINATURA | DATA | | | | TÍTULO:

DESEN.
VERIF.
APROV.
MANUF.
QUALID | | | | MATERIAL: | DES. Nº Redutor_1.5pol-0.25pol_v0 | A4
