Marcus-Reiss/CAD-Backup-LEMI/Backup_20250225/LEMI_platform_v2024/Chapa45/Chapa45_PDF_Cotas.pdf

E E

F F

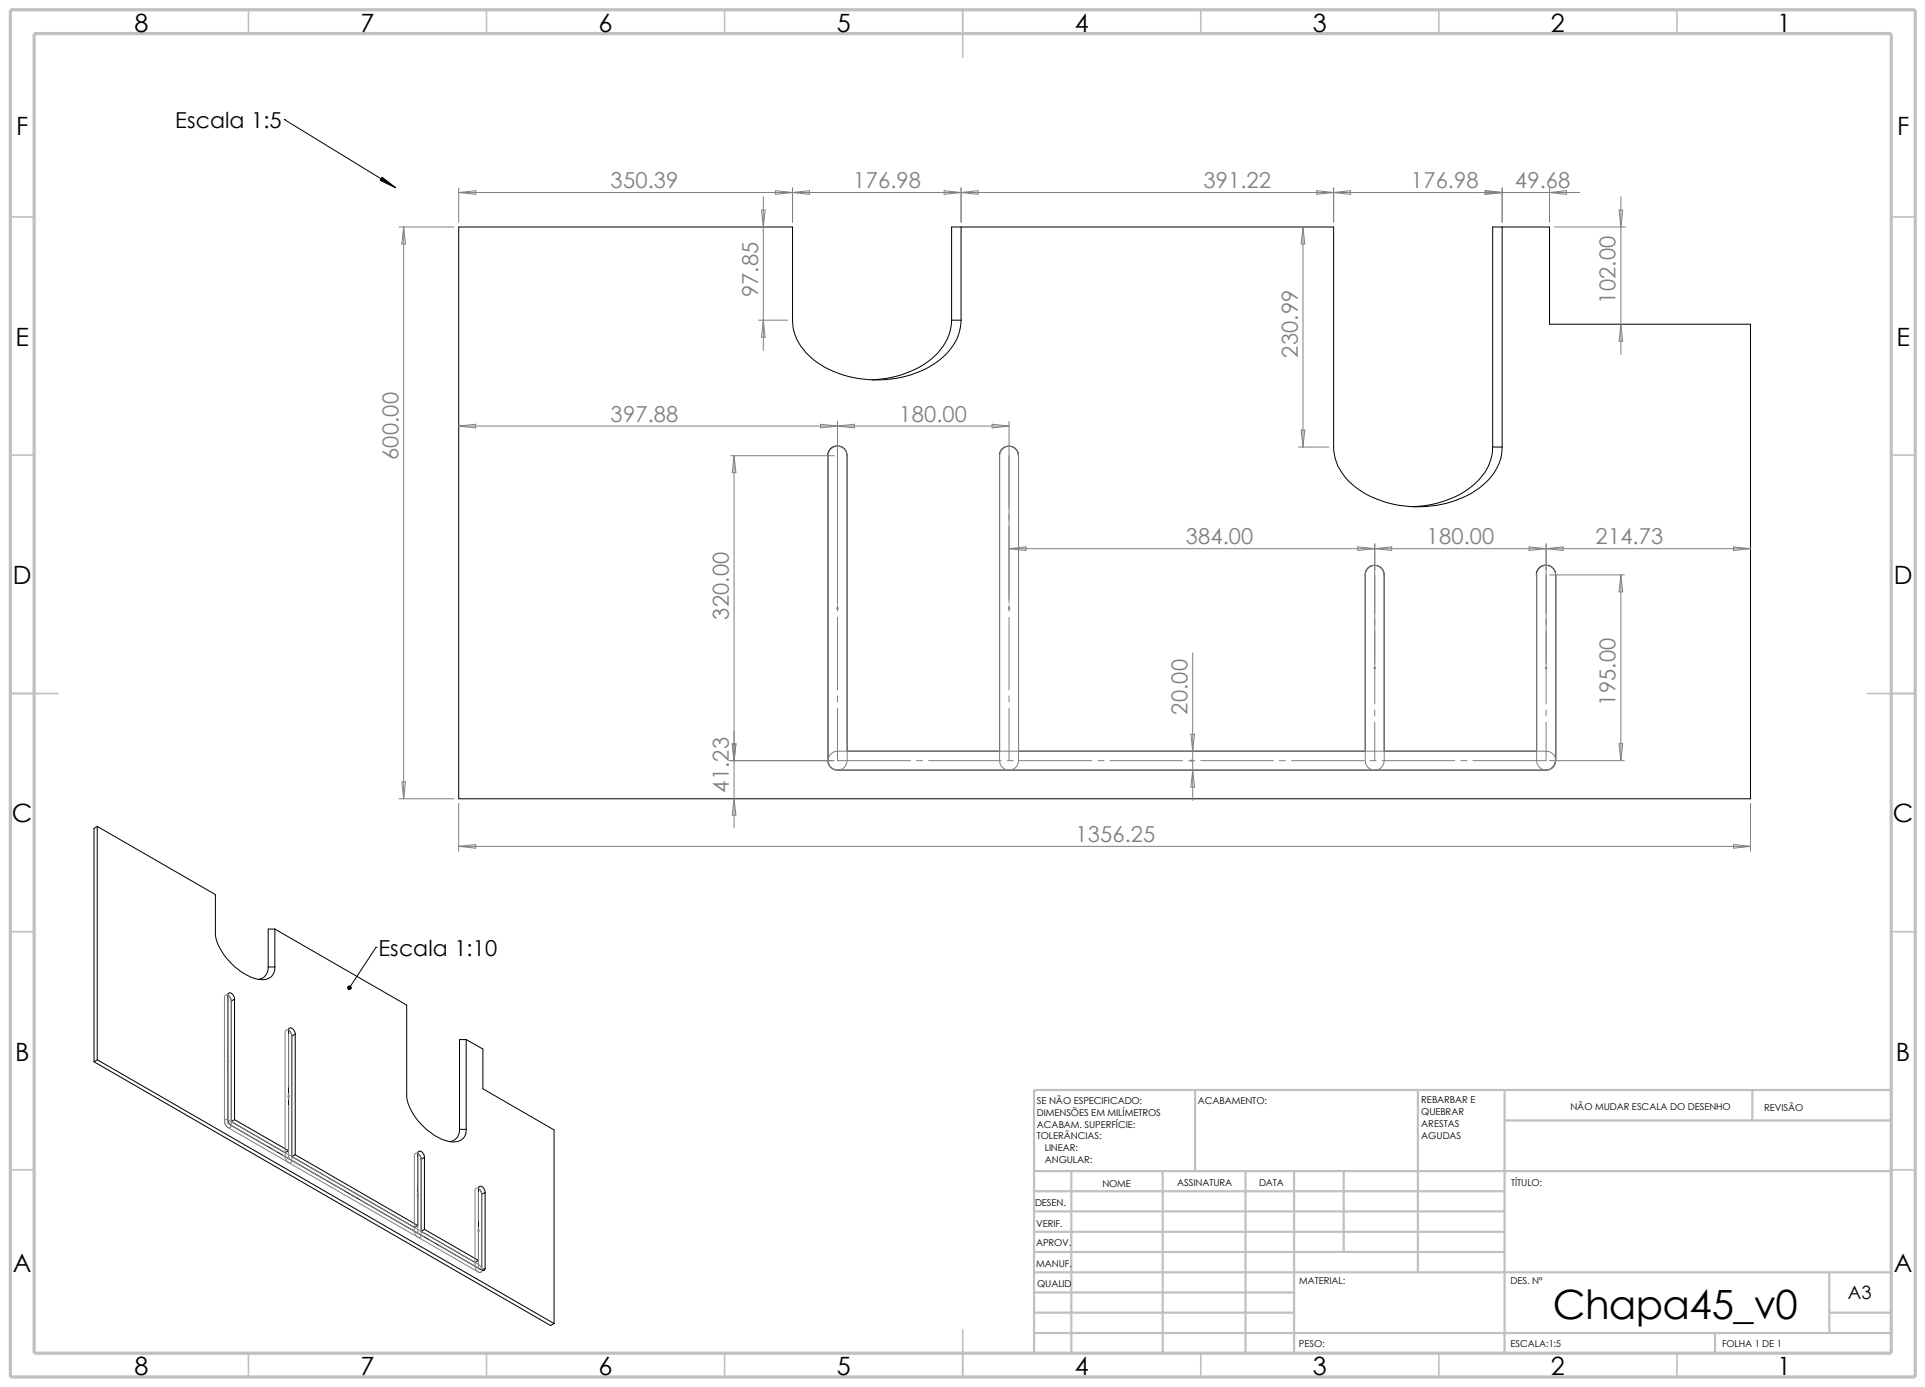
[picture p71: page 1]
REVISÃO; ESCALA:1:5; FOLHA 1 DE 1; PESO:; ACABAMENTO:; AGUDAS; REBARBAR E QUEBRAR ARESTAS; Chapa45_v0 ⁶⁰⁰.00; Escala 1:5; Escala 1:10

SE NÃO ESPECIFICADO:
DIMENSÕES EM MILÍMETROS
ACABAM. SUPERFÍCIE:
TOLERÂNCIAS:
LINEAR:
ANGULAR:

NÃO MUDAR ESCALA DO DESENHO

NOME | ASSINATURA | DATA | | | | TÍTULO:

DESEN.
VERIF.
APROV.

MANUF.
QUALID | | | | MATERIAL: | DES. Nº | A3
