Marcus-Reiss/CAD-Backup-LEMI/Backup_20250225/LEMI_platform_v2024/Projeto Separador/Escotilha_v0.PDF

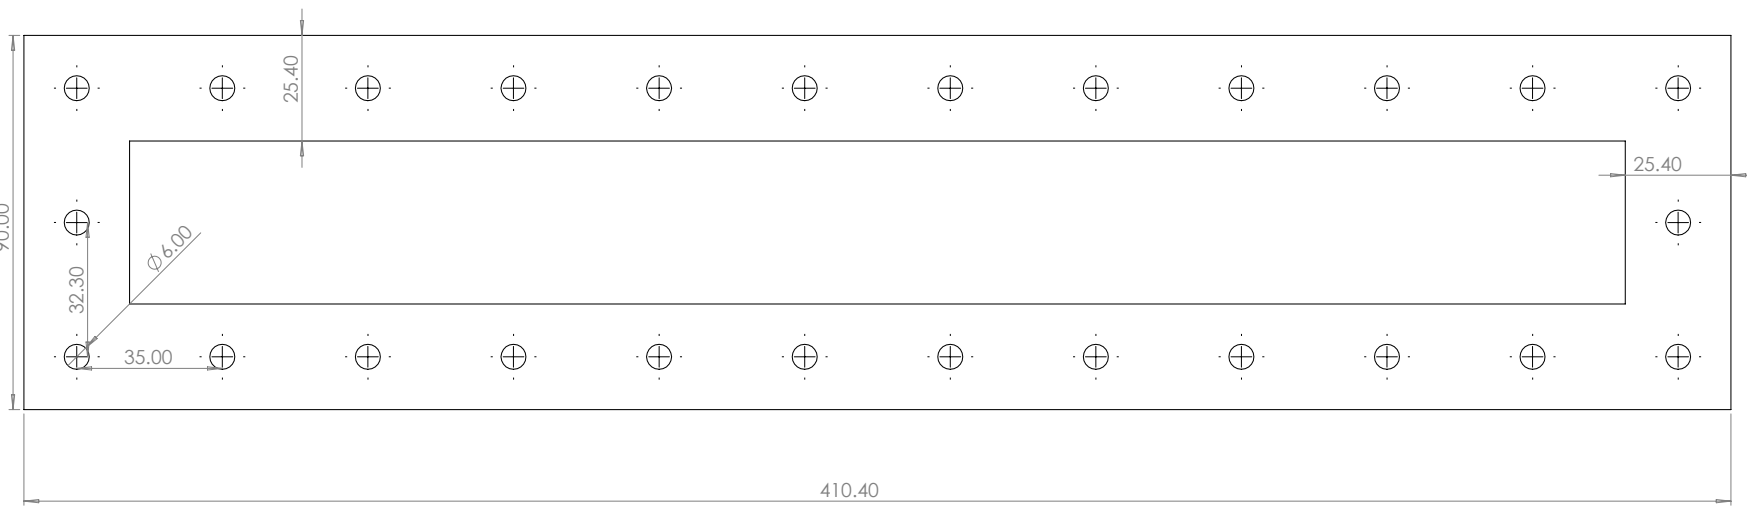
[picture p72: page 1]
