Marcus-Reiss/CAD-Backup-LEMI/Backup-20241219-20250121T215628Z-001/Backup-20241219/LEMI_platform_v2024/Parts_old/Assembly Interno/Cilindro Proposto/MC - Cilindro Hidráulico 56x100xcurso.PDF

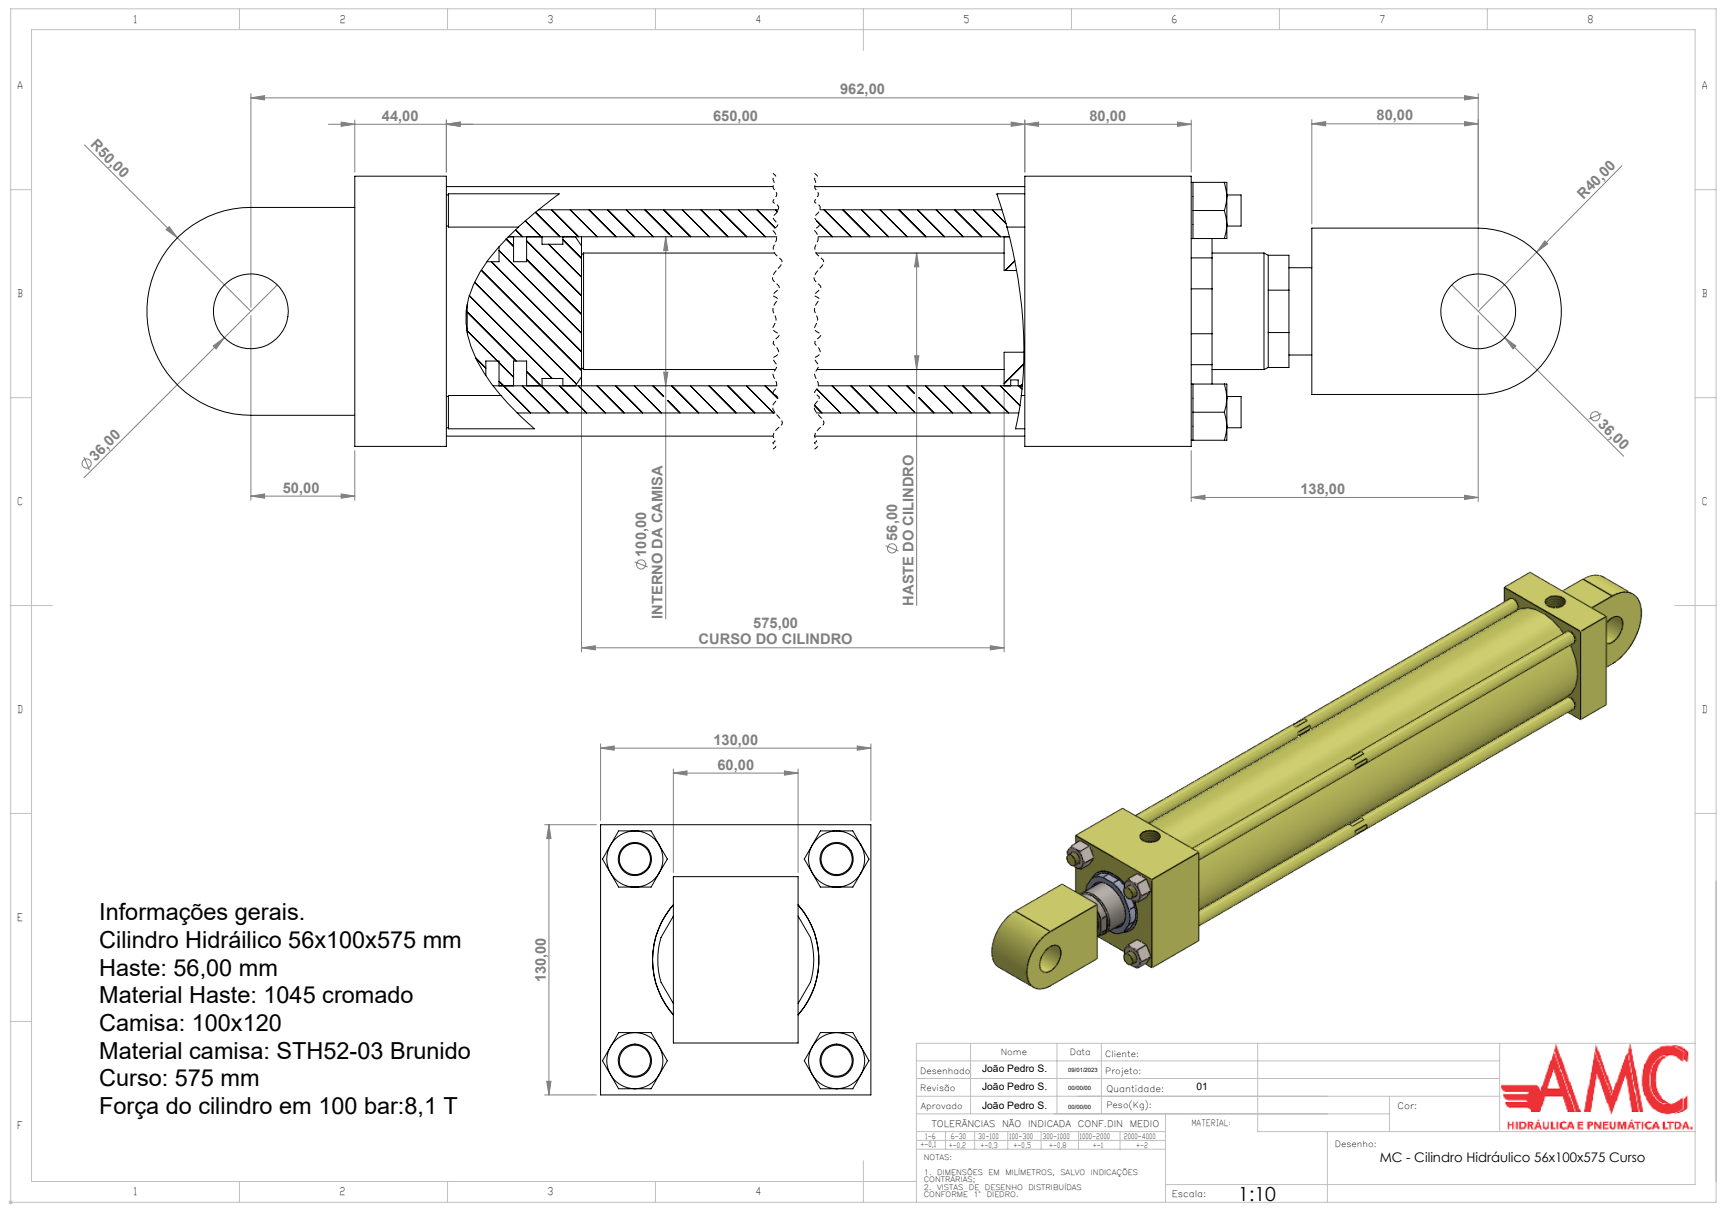
[picture p73: page 1]
Desenho: 6-30

HASTE DO CILINDRO

INTERNO DA CAMISA

CURSO DO CILINDRO

Informações gerais.
Cilindro Hidráilico 56x100x575 mm
Haste: 56,00 mm
Material Haste: 1045 cromado
Camisa: 100x120
Material camisa: STH52-03 Brunido
Curso: 575 mm
Força do cilindro em 100 bar:8,1 T

Nome | Data | Cliente:

Desenhado | João Pedro S. | 09/01/2023 | Projeto:
Revisão | João Pedro S. | 00/00/00 | 01 Quantidade:
Aprovado | João Pedro S. | 00/00/00 | Peso(Kg): | Cor:
TOLERÂNCIAS NÃO INDICADA CONF.DIN MEDIO

NOTAS:
1. DIMENSÕES EM MILÍMETROS, SALVO INDICAÇÕES
CONTRÁRIAS;
2. VISTAS DE DESENHO DISTRIBUÍDAS
CONFORME 1° DIEDRO.

MC - Cilindro Hidráulico 56x100x575 Curso
