Marcus-Reiss/CAD-Backup-LEMI/Backup-20241219-20250121T215628Z-001/Backup-20241219/LEMI_platform_v2024/Parts_old/Planta/BaseMesa.pdf

F

E

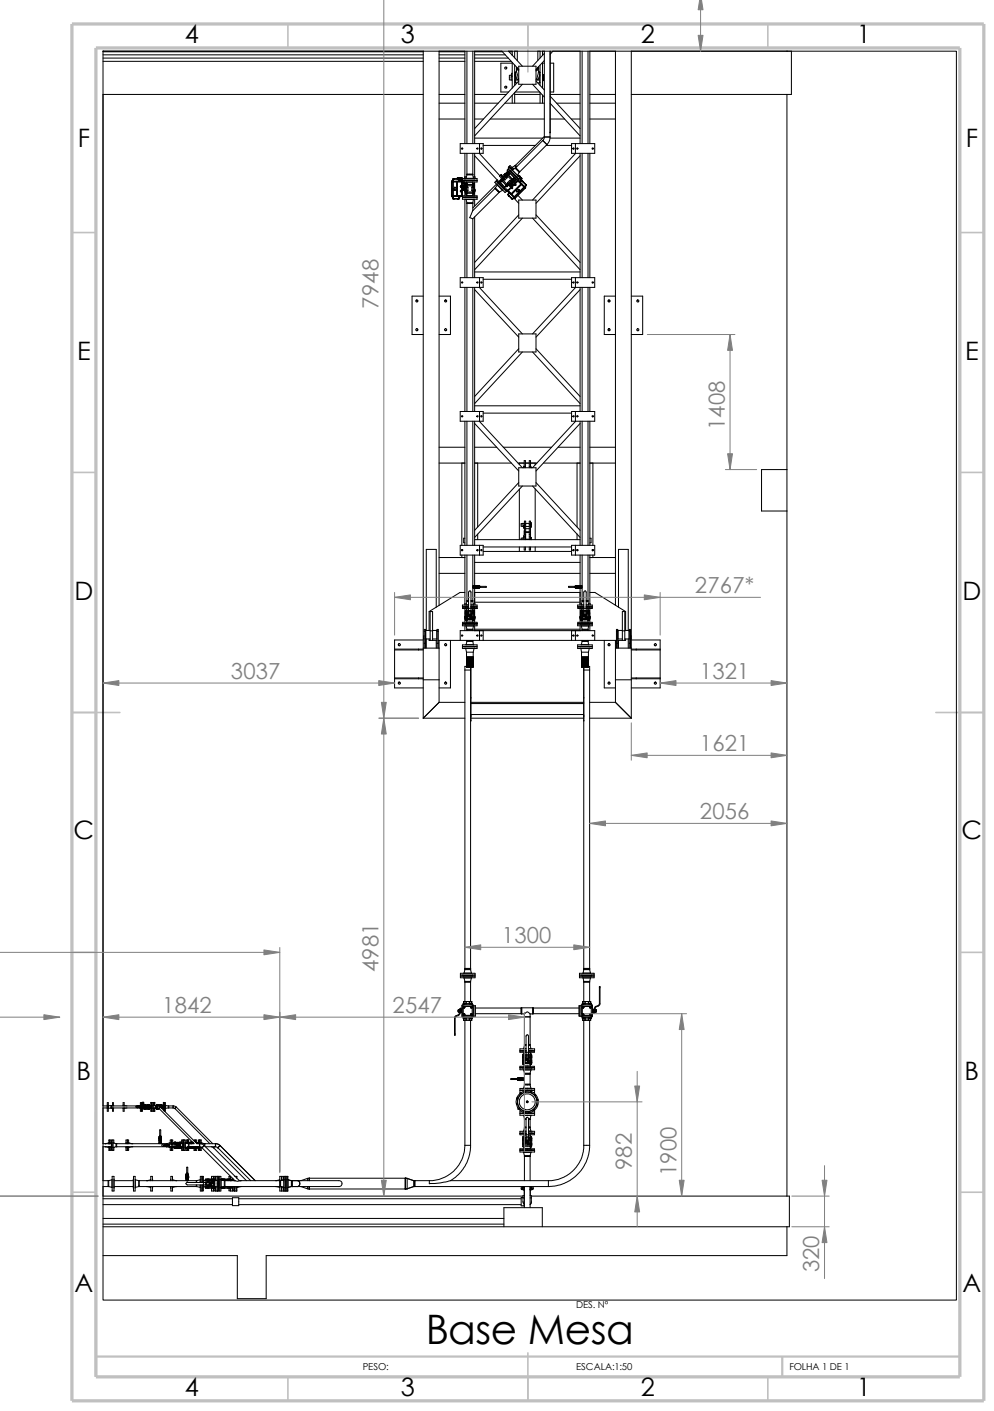
[picture p74: page 1]
DES. Nº; ESCALA:1:50; PESO:; Base Mesa; FOLHA 1 DE 1
