Marcus-Reiss/CAD-Backup-LEMI/Backup-20241219-20250121T215628Z-001/Backup-20241219/LEMI_platform_v2024/Parts_old/Planta/Compressor.pdf

4 2 3

E E

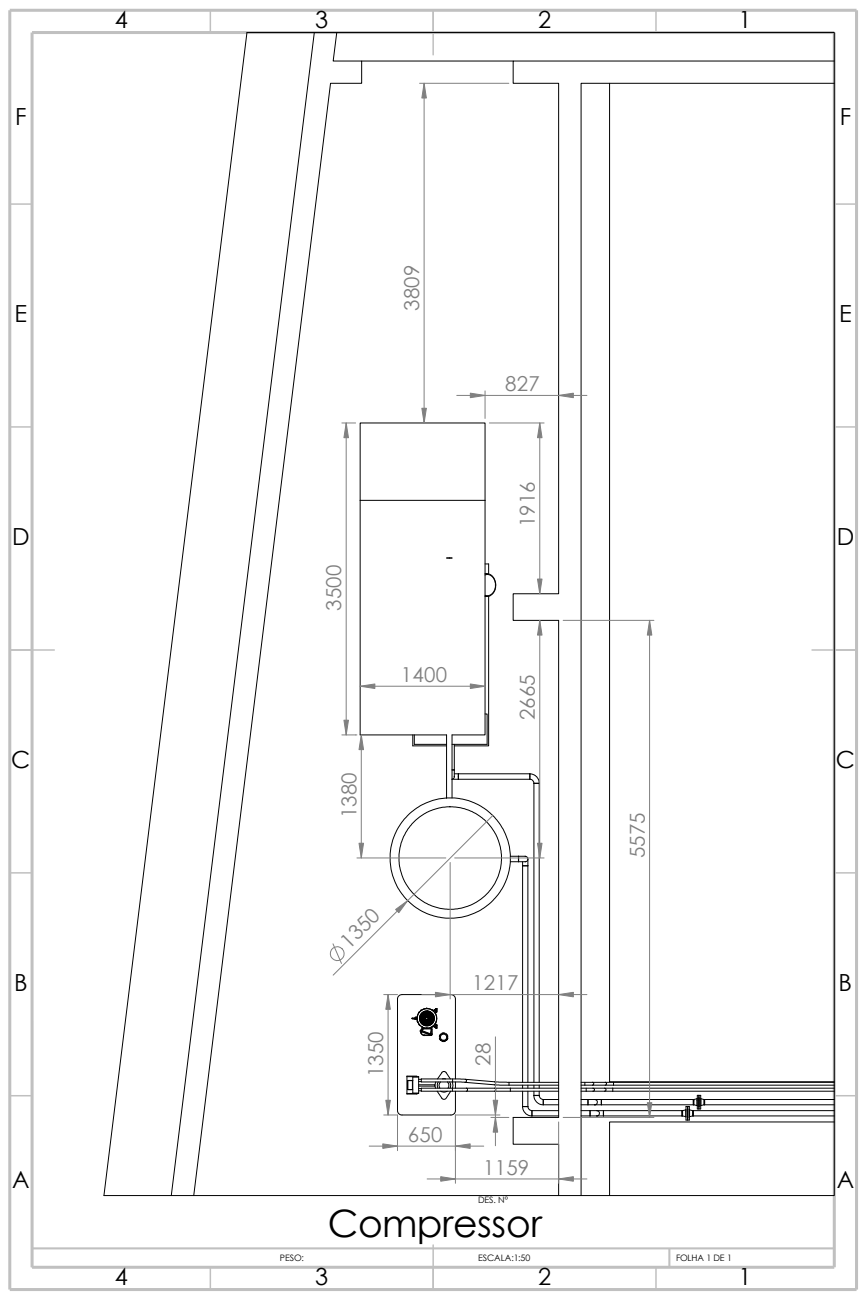
[picture p75: page 1]
1217 ¹³⁸⁰; 650 ³⁵⁰⁰; DES. Nº; PESO:; ESCALA:1:50; FOLHA 1 DE 1; Compressor
