Marcus-Reiss/CAD-Backup-LEMI/Backup-20241219-20250121T215628Z-001/Backup-20241219/LEMI_platform_v2024/Parts_old/Planta/Motobomba.pdf

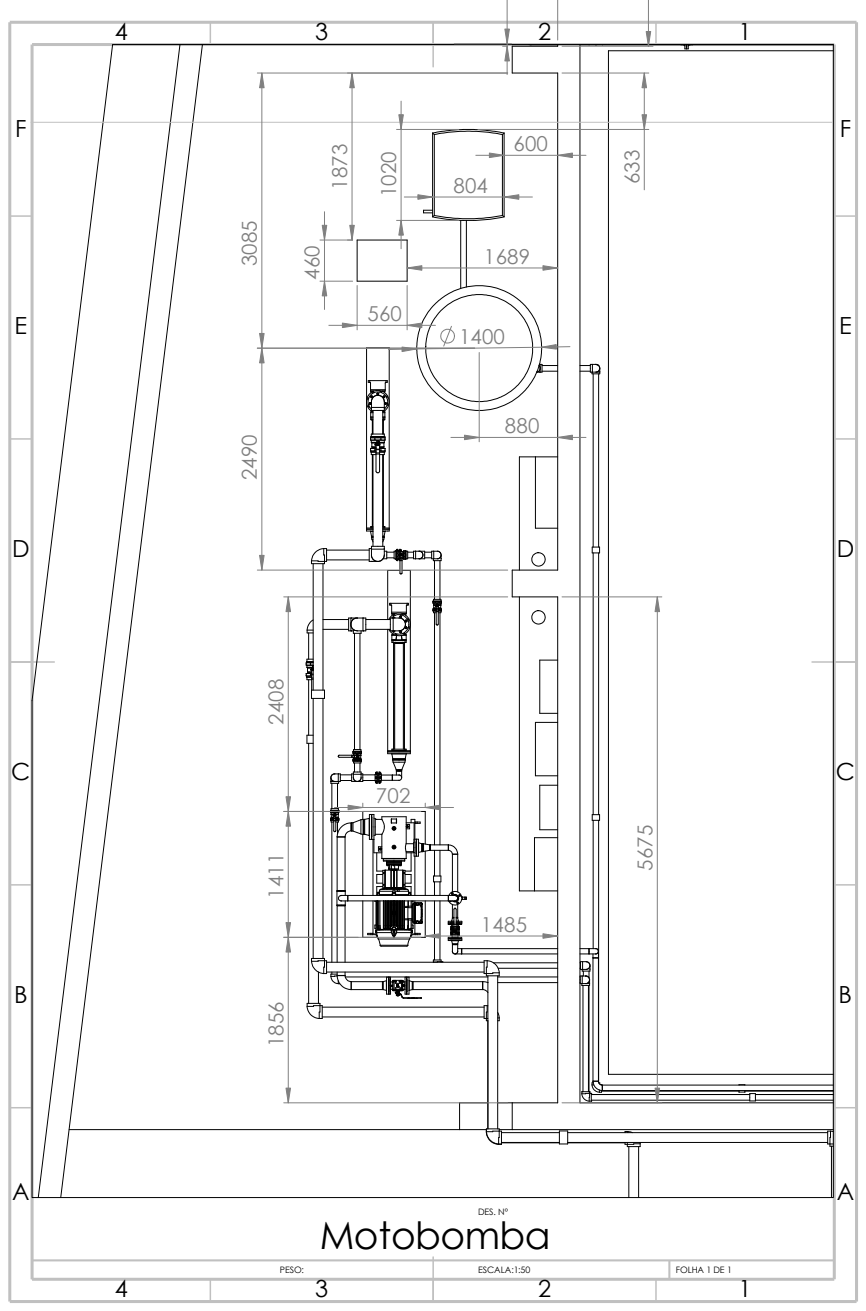
[picture p77: page 1]
DES. Nº; ESCALA:1:50; PESO:; FOLHA 1 DE 1; Motobomba; 600 1689 ¹⁸⁷³ 1020; 1400 ⁴⁶⁰ ³⁰⁸⁵ 2490
