Marcus-Reiss/CAD-Backup-LEMI/Backup-20241219-20250121T215628Z-001/Backup-20241219/LEMI_platform_v2024/Parts_old/Planta/patio.pdf

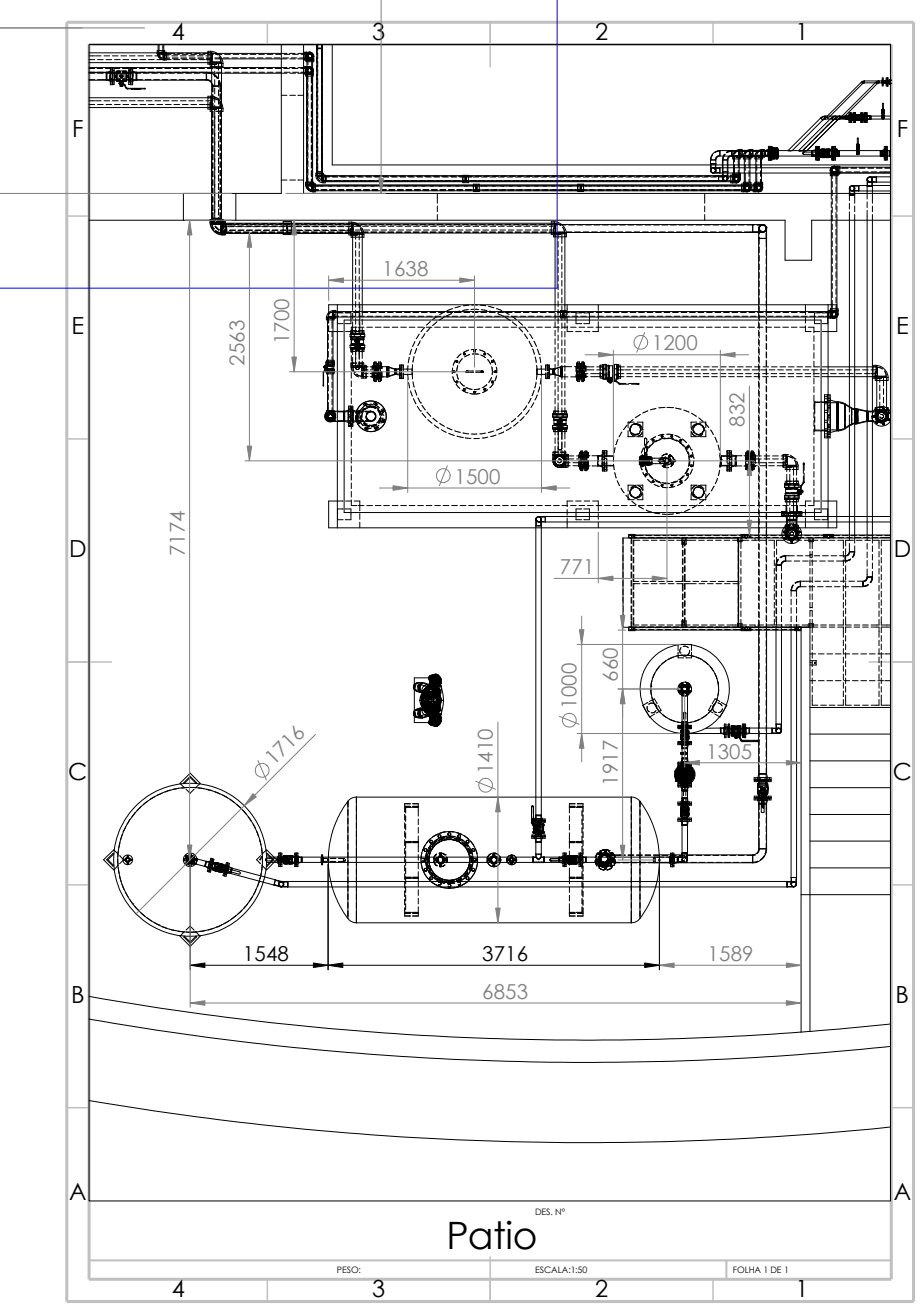
[picture p78: page 1]
1589 ¹⁹¹⁷; ESCALA:1:50; DES. Nº; PESO:; FOLHA 1 DE 1; Patio; 6853 ⁷¹⁷⁴
