Marcus-Reiss/CAD-Backup-LEMI/Backup-20241219-20250121T215628Z-001/Backup-20241219/LEMI_platform_v2024/Parts_old/Planta/portão.pdf

4

3 2

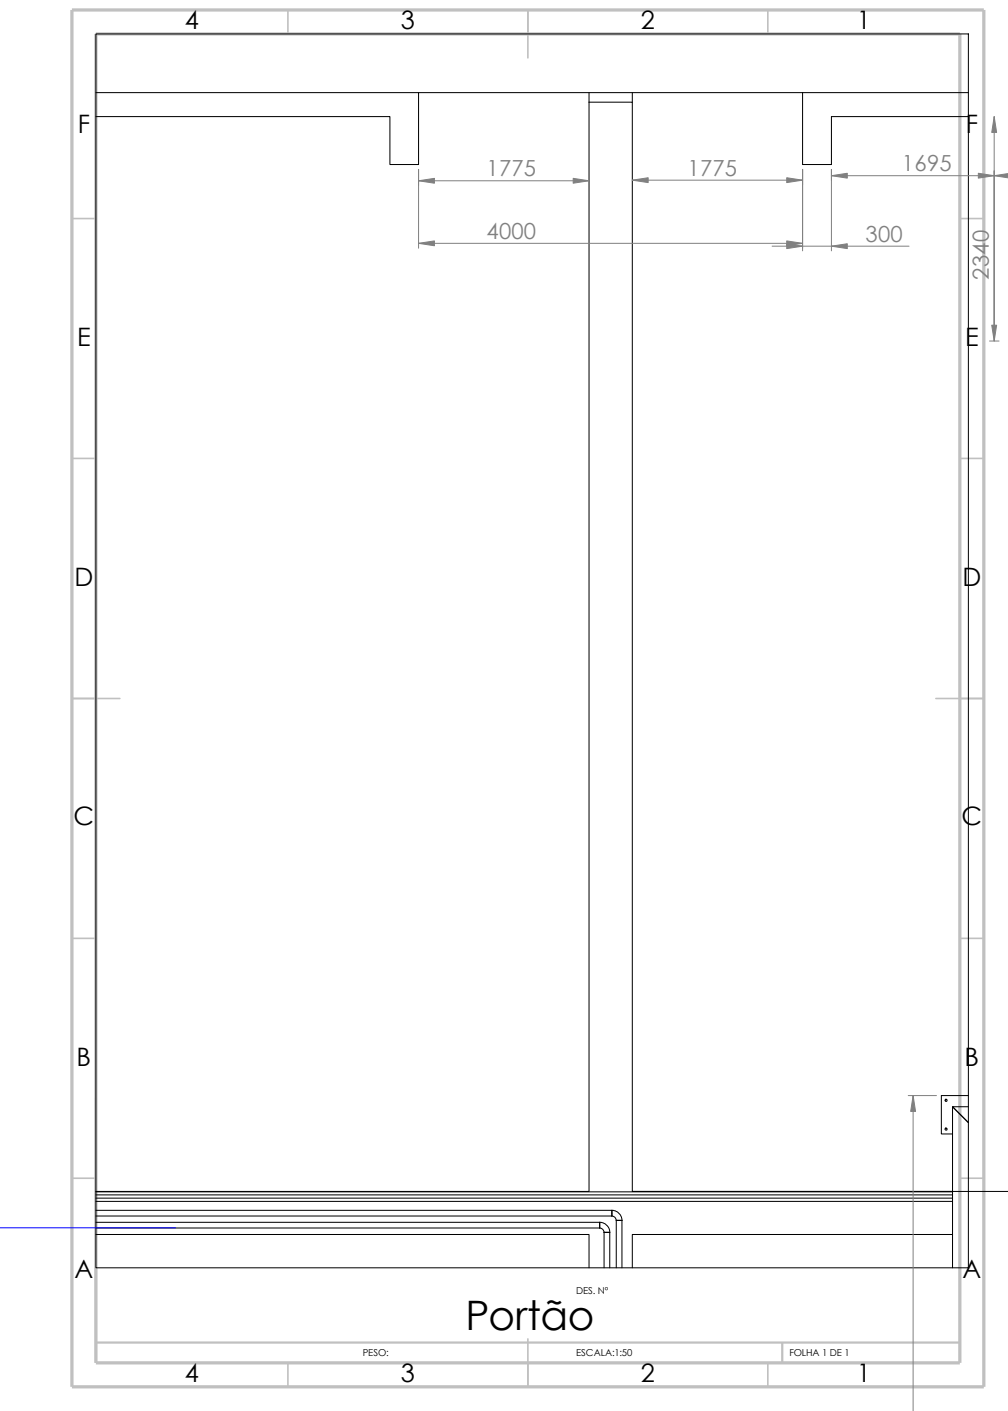
[picture p79: page 1]
DES. Nº; PESO:; ESCALA:1:50; FOLHA 1 DE 1; Portão
