Marcus-Reiss/CAD-Backup-LEMI/Backup-20241219-20250121T215628Z-001/Backup-20241219/LEMI_platform_v2024/Parts_old/Planta/tubulações.pdf

3 2

E E

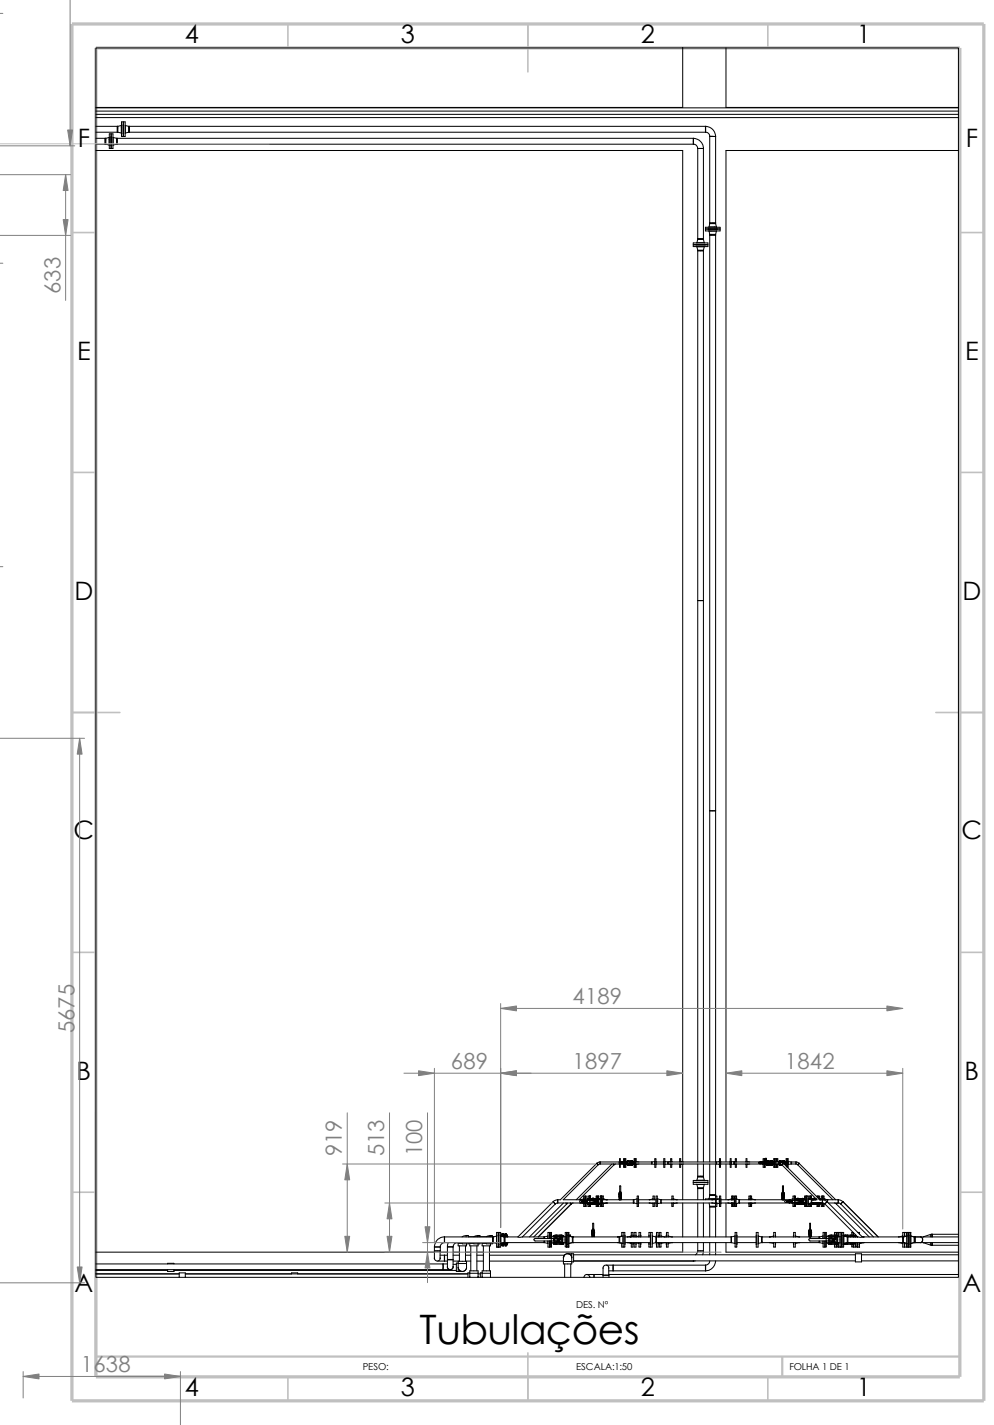
[picture p80: page 1]
ESCALA:1:50; Tubulações; FOLHA 1 DE 1; PESO:; DES. Nº; 4189 ⁶³³; 1638 ⁵⁶⁷⁵
